fgervais/kicad-library/0ZCJ0050AF2E/0ZCJ0050AF2E.step

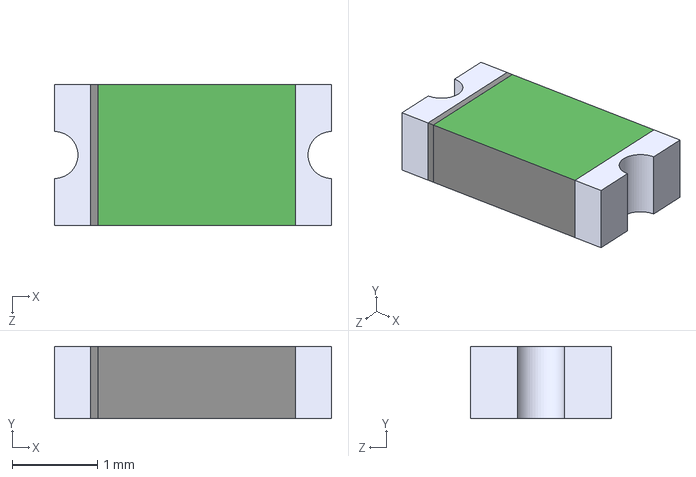
[picture p1: CAD file, 2022-11-03]
0ZCJ0050AF2E/0ZCJ0050AF2E.step
3.25 x 0.85 x 1.65 mm
