fgervais/kicad-library/1571563-9/c-1571563-9-v-3d.stp

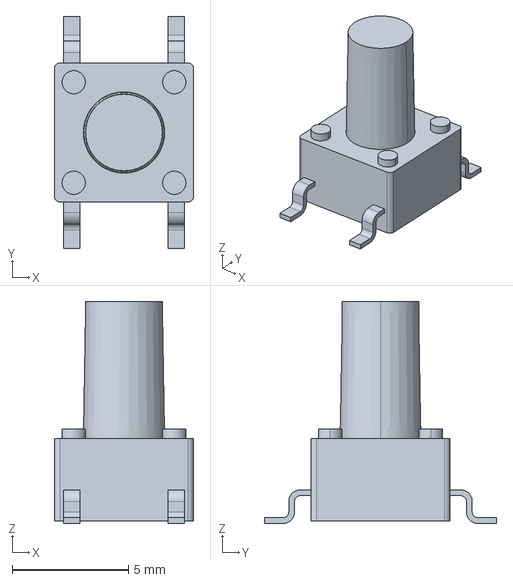
[picture p2: CAD file, 2022-03-16]
1571563-9/c-1571563-9-v-3d.stp
6.00 x 10.0 x 9.56 mm
