fgervais/kicad-library/22R686MC/22R686MC.step

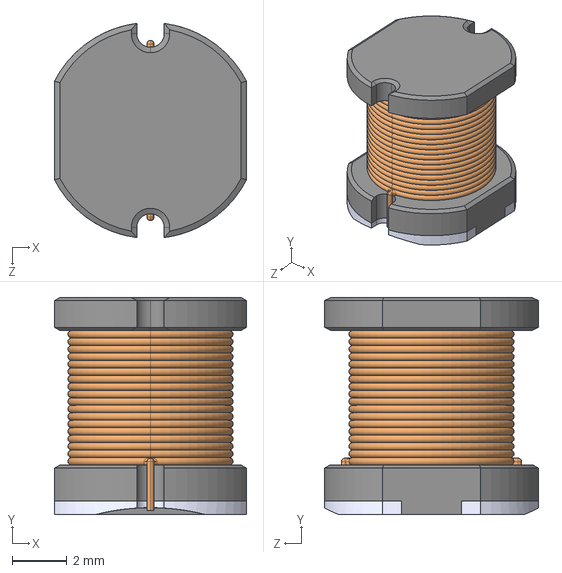
[picture p3: CAD file, 2022-11-13]
22R686MC/22R686MC.step
7.00 x 7.90 x 7.80 mm
