fgervais/kicad-library/3dmodels/C_0603_1608Metric.step

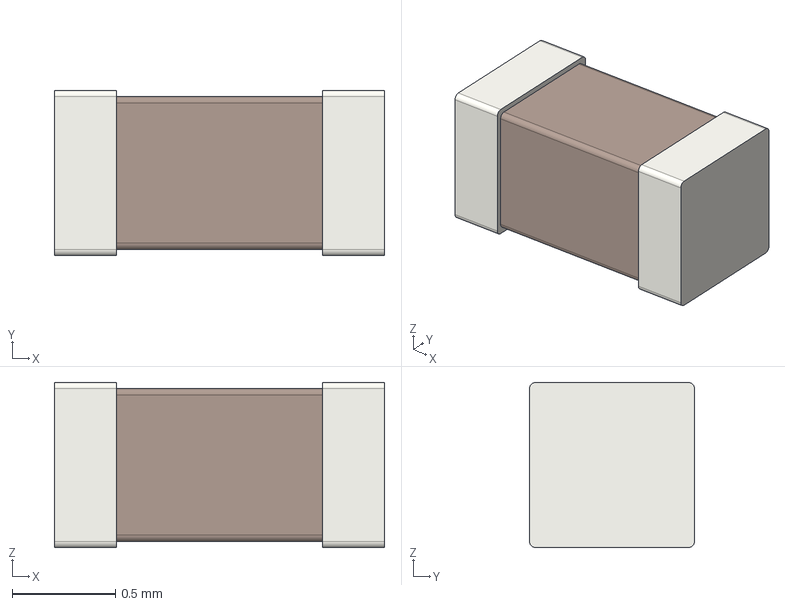
[picture p4: CAD file, 2026-03-07]
3dmodels/C_0603_1608Metric.step
1.60 x 0.8 x 0.8 mm
