fgervais/kicad-library/ADS1219IPWR/ADS1219IPWR.step

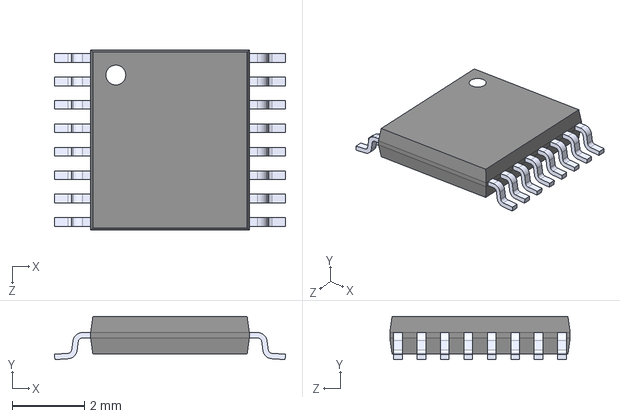
[picture p5: CAD file, 2022-04-10]
ADS1219IPWR/ADS1219IPWR.step
6.40 x 1.20 x 5.00 mm
