fgervais/kicad-library/AP63300WU-7/sot-23-6.stp

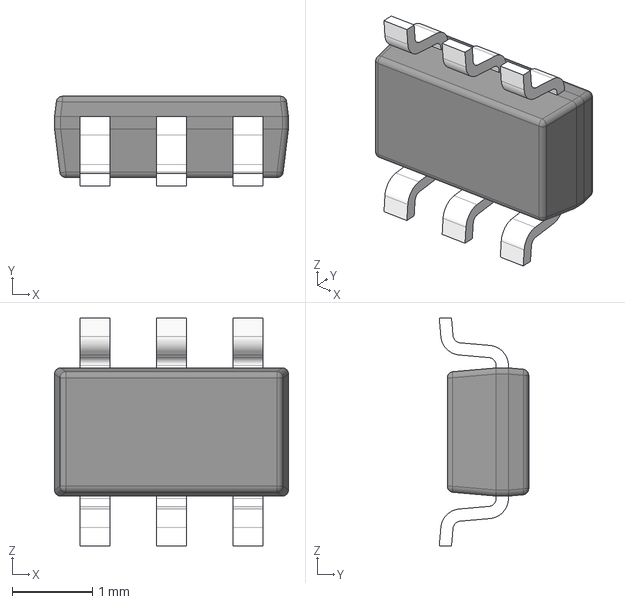
[picture p6: CAD file, 2023-01-06]
AP63300WU-7/sot-23-6.stp
2.92 x 1.12 x 2.84 mm
BODY_MF06A
LEAD_MF06A x 6
