fgervais/kicad-library/AS7341-DLGT/AS7341-DLGT.step

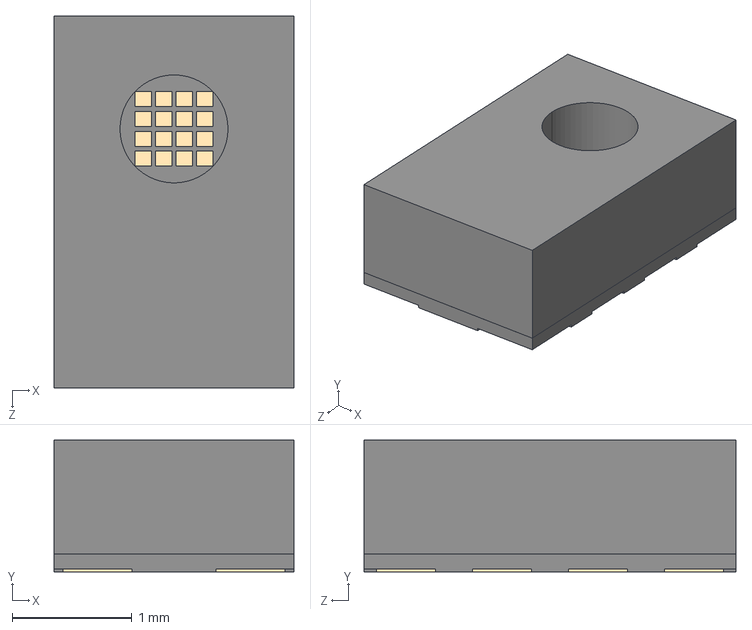
[picture p7: CAD file, 2022-04-02]
AS7341-DLGT/AS7341-DLGT.step
2.00 x 1.10 x 3.10 mm
