fgervais/kicad-library/B2B-PH-K-S(LF)(SN)/B2B-PH-K-S(LF)(SN)--3DModel-STEP-56544.STEP

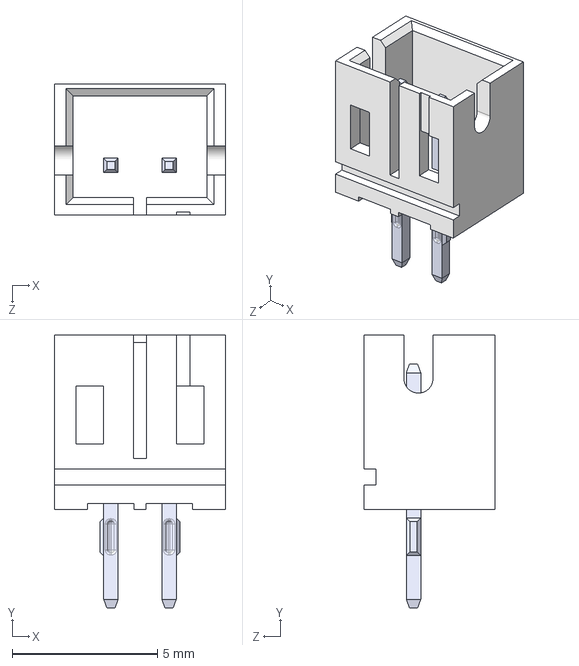
[picture p8: CAD file, 2020-11-15]
B2B-PH-K-S(LF)(SN)/B2B-PH-K-S(LF)(SN)--3DModel-STEP-56544.STEP
5.90 x 9.40 x 4.50 mm
