fgervais/kicad-library/B3FS-1010/B3FS-1010.stp

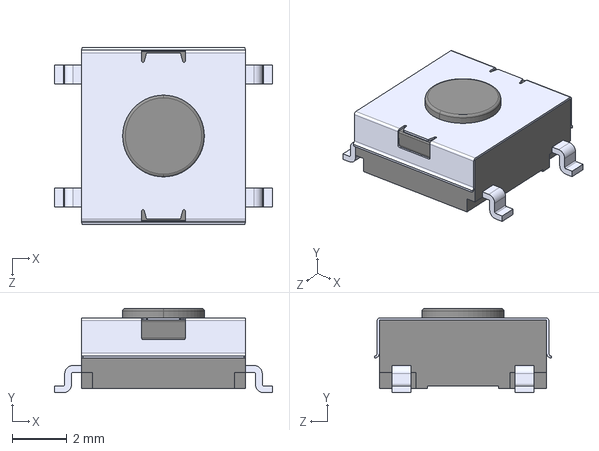
[picture p9: CAD file, 2022-03-24]
B3FS-1010/B3FS-1010.stp
8.00 x 3.10 x 6.50 mm
