fgervais/kicad-library/BA2032SM/BA2032SM.step

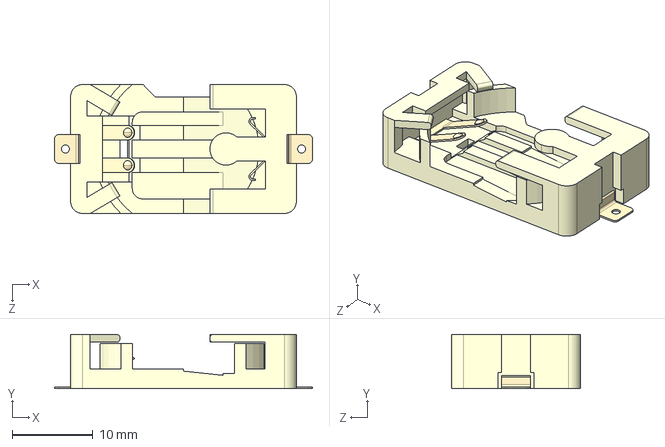
[picture p10: CAD file, 2022-03-16]
BA2032SM/BA2032SM.step
32.0 x 6.70 x 16.0 mm
