fgervais/kicad-library/BK-5058-SM/BK-5058-SM.step

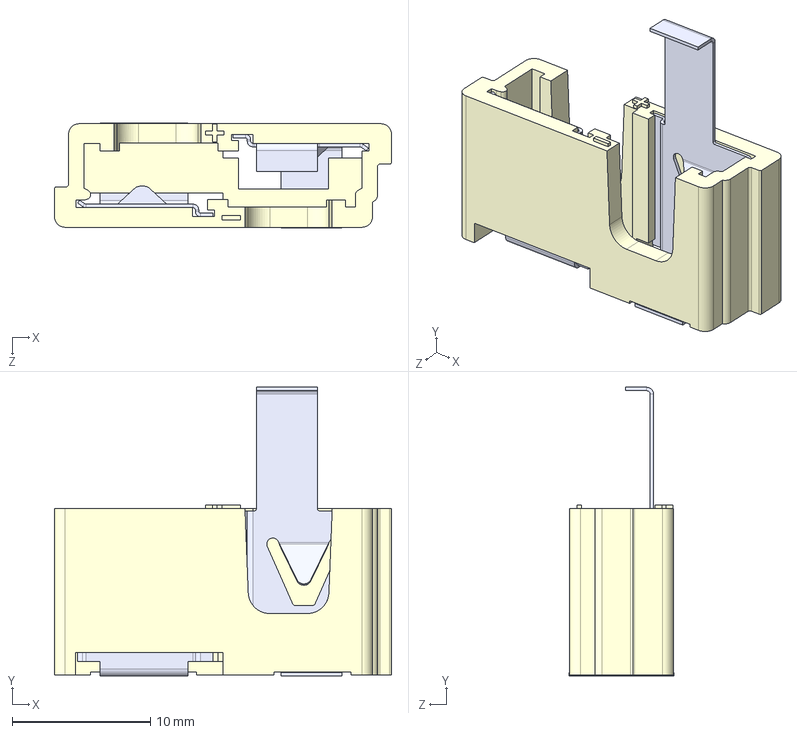
[picture p11: CAD file, 2022-11-15]
BK-5058-SM/BK-5058-SM.step
24.4 x 20.9 x 7.57 mm
