fgervais/kicad-library/BK-912/BK-912-TR.step

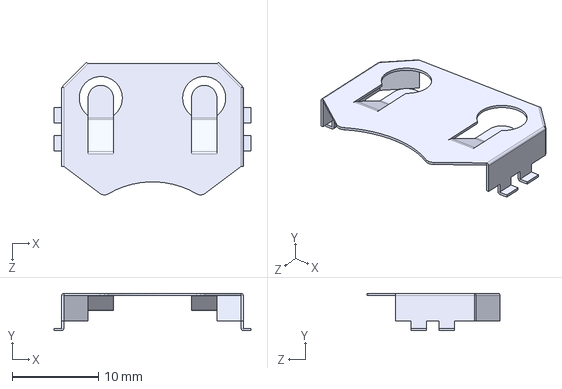
[picture p12: CAD file, 2022-11-17]
BK-912/BK-912-TR.step
22.9 x 4.32 x 15.4 mm
