fgervais/kicad-library/BM06B-SRSS-TB(LF)(SN)/BM06B-SRSS-TB.STEP

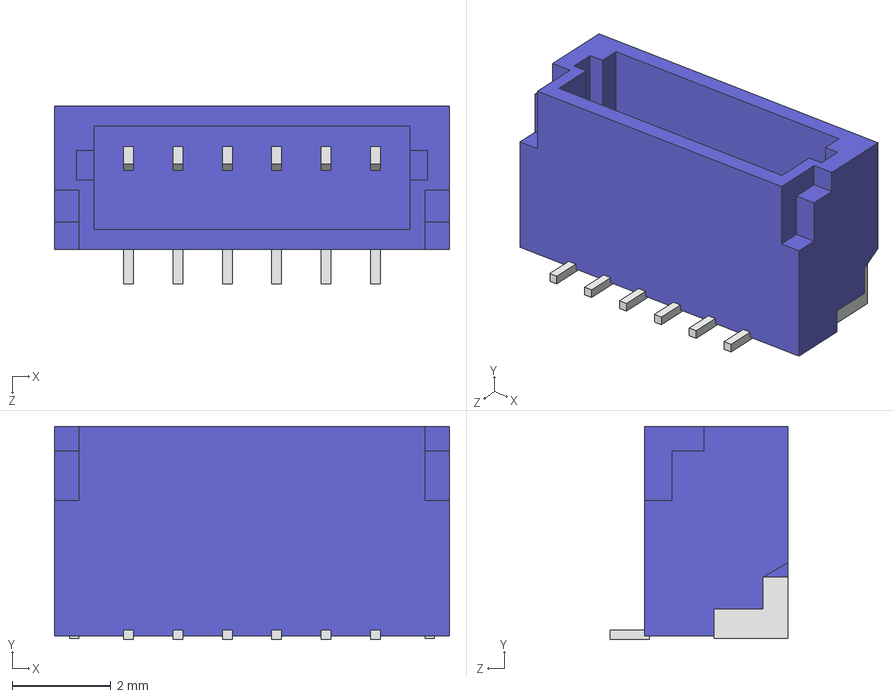
[picture p13: CAD file, 2021-02-07]
BM06B-SRSS-TB(LF)(SN)/BM06B-SRSS-TB.STEP
8.00 x 4.32 x 3.60 mm
