fgervais/kicad-library/BSS138W/SOT-323_SC-70.step

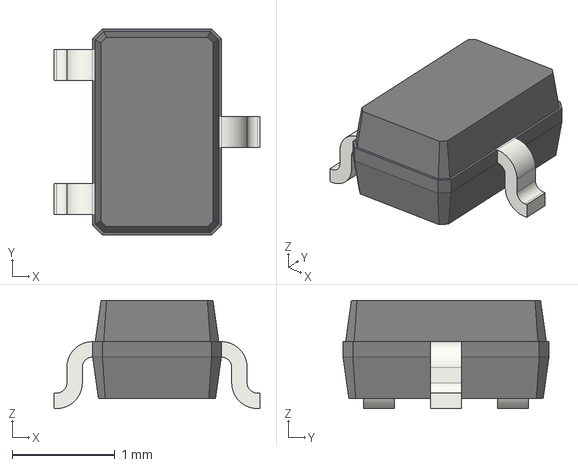
[picture p14: CAD file, 2024-10-14]
BSS138W/SOT-323_SC-70.step
2.00 x 2.00 x 1.05 mm
