fgervais/kicad-library/CL-SB-22A-02T/CL-SB-22A-02T.step

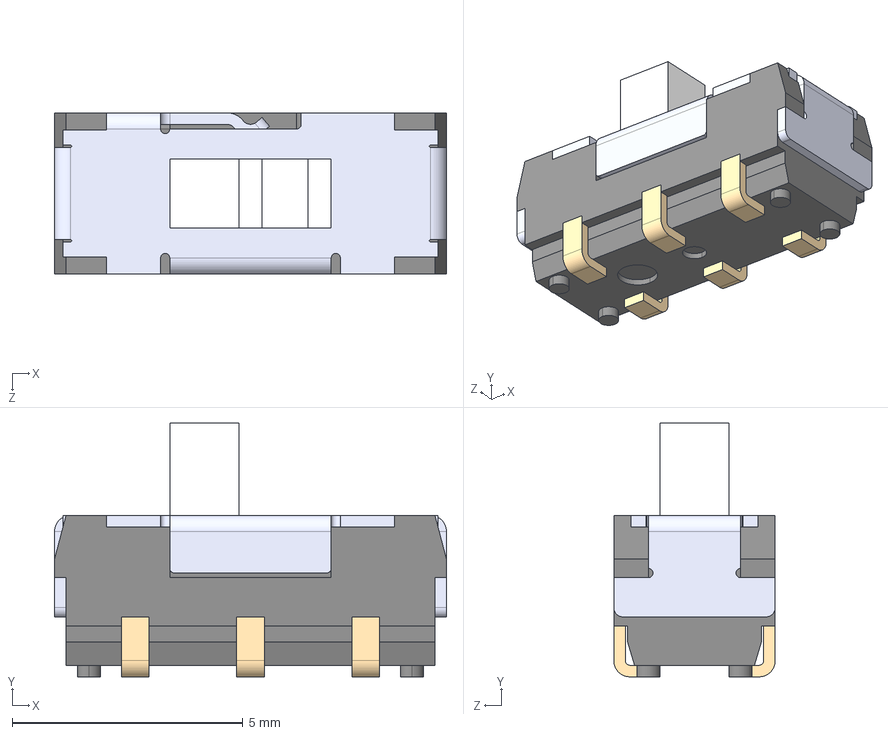
[picture p15: CAD file, 2022-11-02]
CL-SB-22A-02T/CL-SB-22A-02T.step
8.50 x 5.50 x 3.50 mm
