fgervais/kicad-library/CNCTECH_3220-26-0200-00/3220-26-0200-00.stp

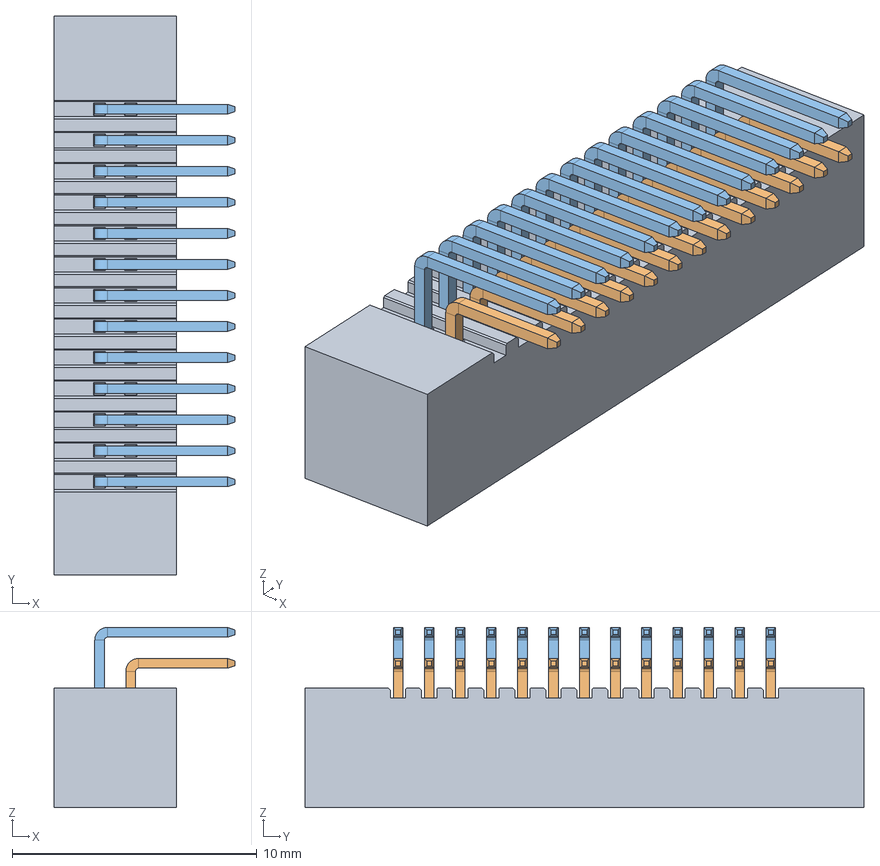
[picture p16: CAD file, 2025-05-09]
CNCTECH_3220-26-0200-00/3220-26-0200-00.stp
7.40 x 22.9 x 7.37 mm
801-2195R-26
802-2195R-XXG-L x 13
802-2195R-XXG x 13
