fgervais/kicad-library/CNCTECH_3220-26-0300-00/3220-26-0300-00.step

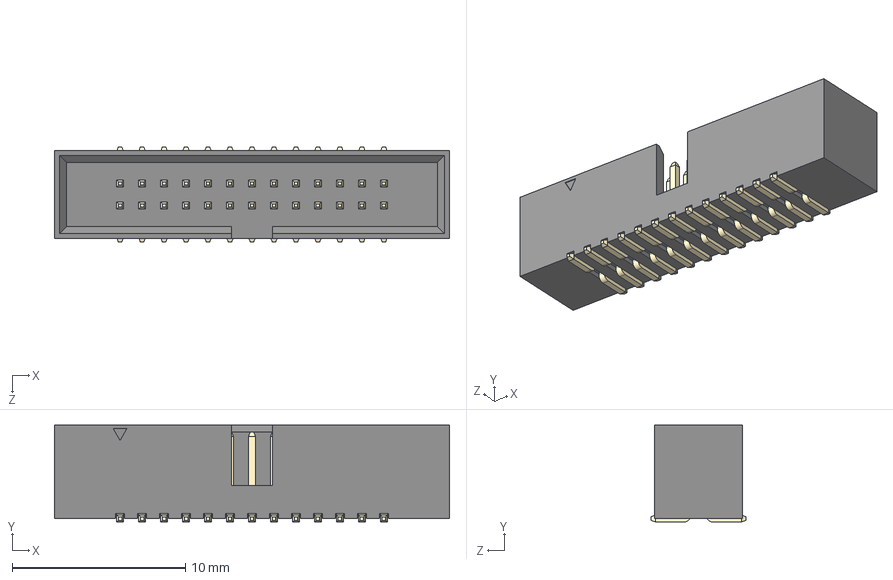
[picture p17: CAD file, 2025-05-14]
CNCTECH_3220-26-0300-00/3220-26-0300-00.step
22.8 x 5.60 x 5.50 mm
3220-xx-0300-00 body_26
Pin^3220-xx-0300-00 x 13
MirrorPin^3220-xx-0300-00 x 13
