fgervais/kicad-library/Conn_Molex_393570002/Molex_-_393570002.step

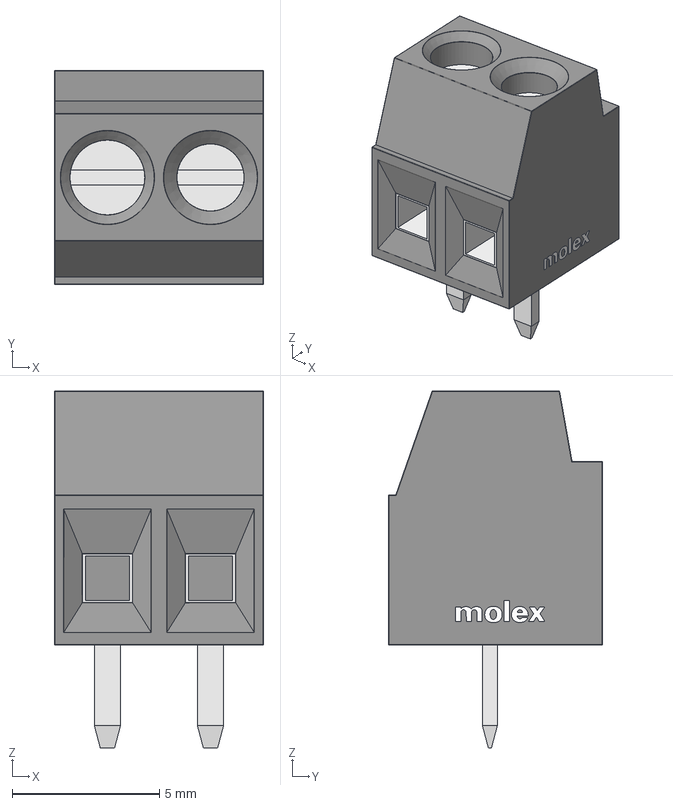
[picture p18: CAD file, 2021-02-07]
Conn_Molex_393570002/Molex_-_393570002.step
7.11 x 7.29 x 12.1 mm
393570002_Body
393570002_Contacts
393570002_Screw
393570002_Terminals
Molex
