fgervais/kicad-library/Conn_Molex_393570004/Molex_-_393570004.step

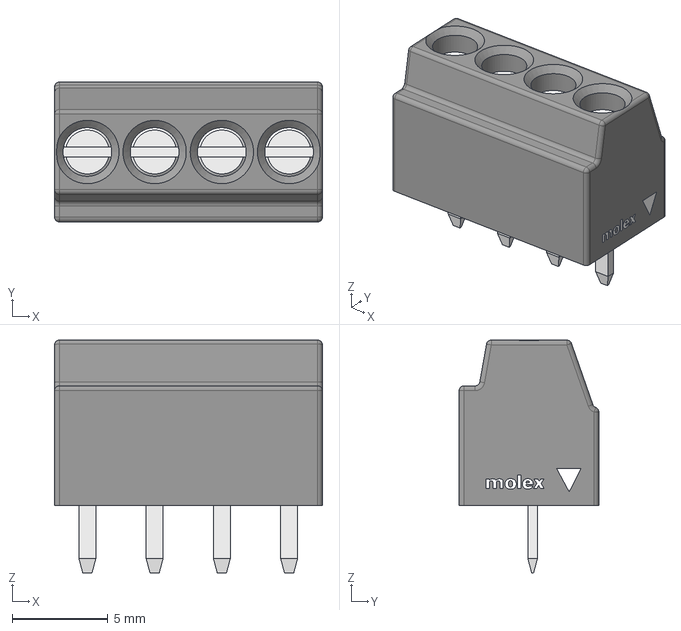
[picture p19: CAD file, 2021-02-07]
Conn_Molex_393570004/Molex_-_393570004.step
14.0 x 7.29 x 12.1 mm
