fgervais/kicad-library/CUS10S30,H3F/DIO_CUS520_H3F.step

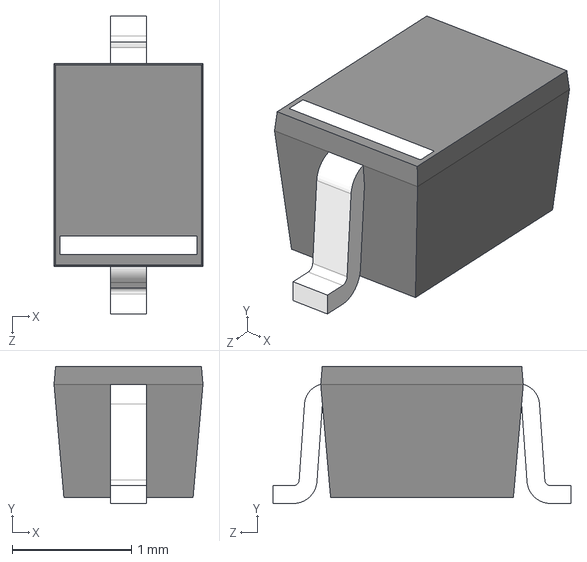
[picture p20: CAD file, 2022-01-06]
CUS10S30,H3F/DIO_CUS520_H3F.step
1.25 x 1.15 x 2.50 mm
