fgervais/kicad-library/DS2482S-100/DS2482S-100_.step

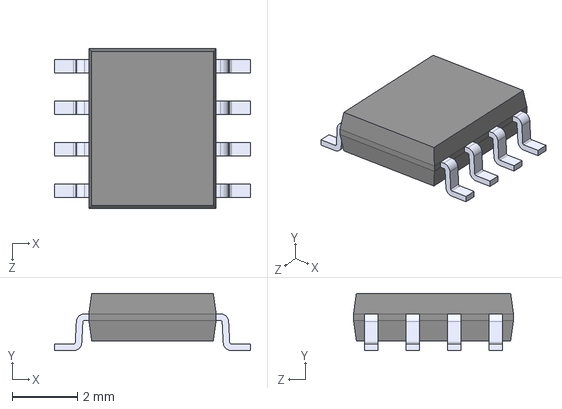
[picture p21: CAD file, 2021-08-31]
DS2482S-100/DS2482S-100_.step
6.00 x 1.75 x 4.90 mm
