fgervais/kicad-library/ESP32-C3-WROOM-02-H4/ESP32-C3-WROOM-02-H4.step

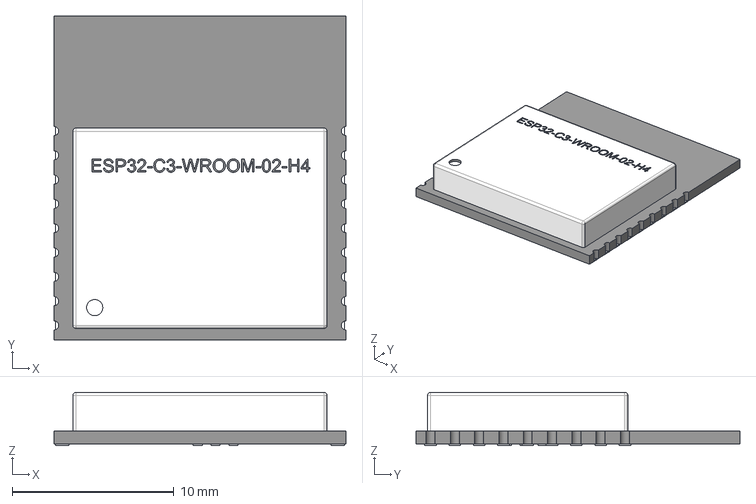
[picture p22: CAD file, 2021-09-25]
ESP32-C3-WROOM-02-H4/ESP32-C3-WROOM-02-H4.step
18.0 x 20.0 x 3.30 mm
Pins
