fgervais/kicad-library/ISM330DHCXTR/ISM330DHCXTR.step

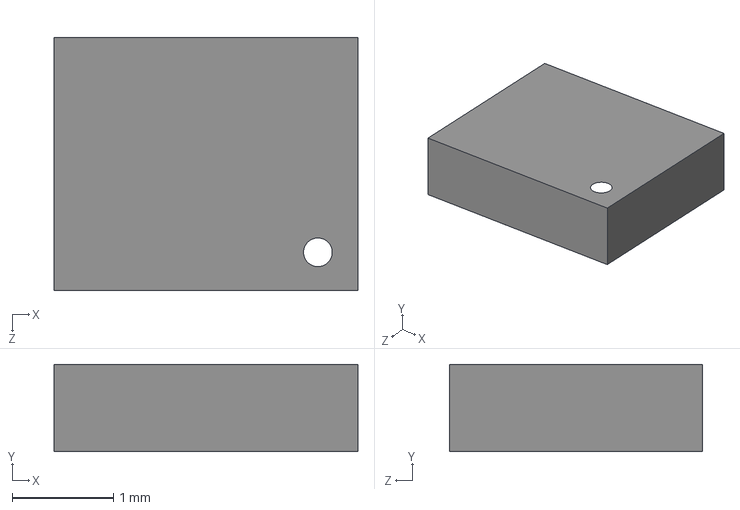
[picture p23: CAD file, 2022-09-17]
ISM330DHCXTR/ISM330DHCXTR.step
3.00 x 0.86 x 2.50 mm
