fgervais/kicad-library/LBR2518T100K/L_QEA251818.STEP

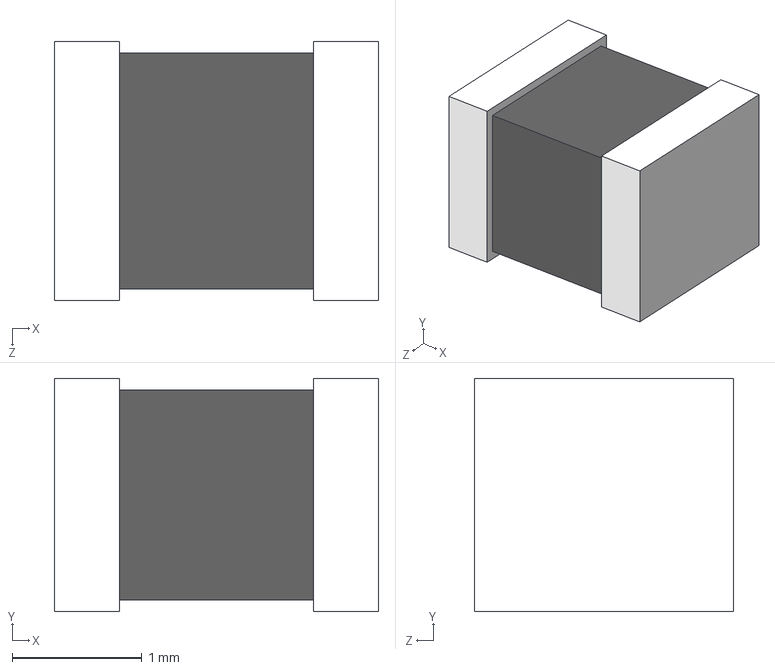
[picture p24: CAD file, 2023-01-07]
LBR2518T100K/L_QEA251818.STEP
2.50 x 1.80 x 2.00 mm
