fgervais/kicad-library/LMV792MM/LMV792MM.step

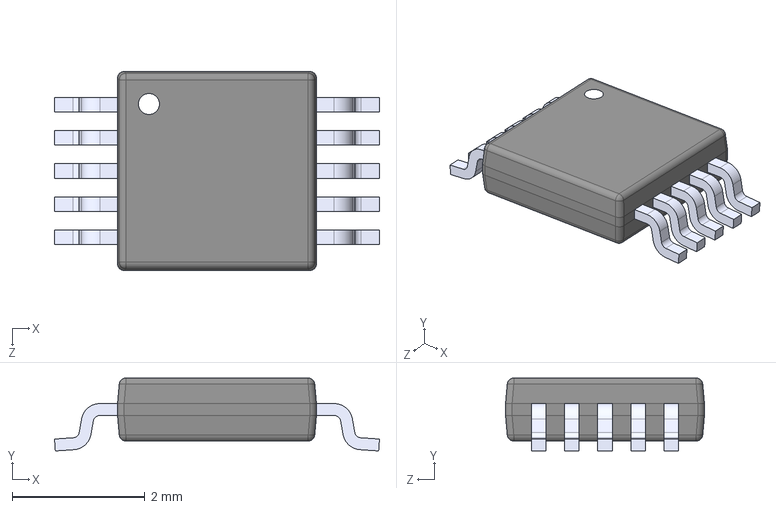
[picture p25: CAD file, 2022-04-22]
LMV792MM/LMV792MM.step
4.90 x 1.10 x 3.00 mm
