fgervais/kicad-library/LSF0204DPWR/LSF0204DPWR.step

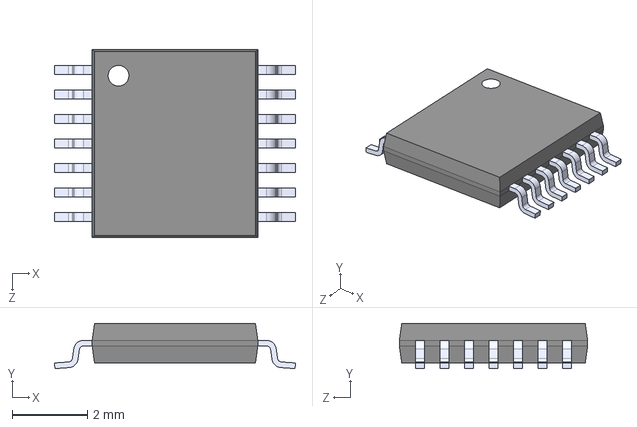
[picture p26: CAD file, 2022-04-10]
LSF0204DPWR/LSF0204DPWR.step
6.40 x 1.20 x 5.00 mm
