fgervais/kicad-library/MELEXIS_TECHNOLOGIES_NV_MLX90640ESF-BAA-000-TU/a549d9fa911df849d05683749dd4367124007292.step

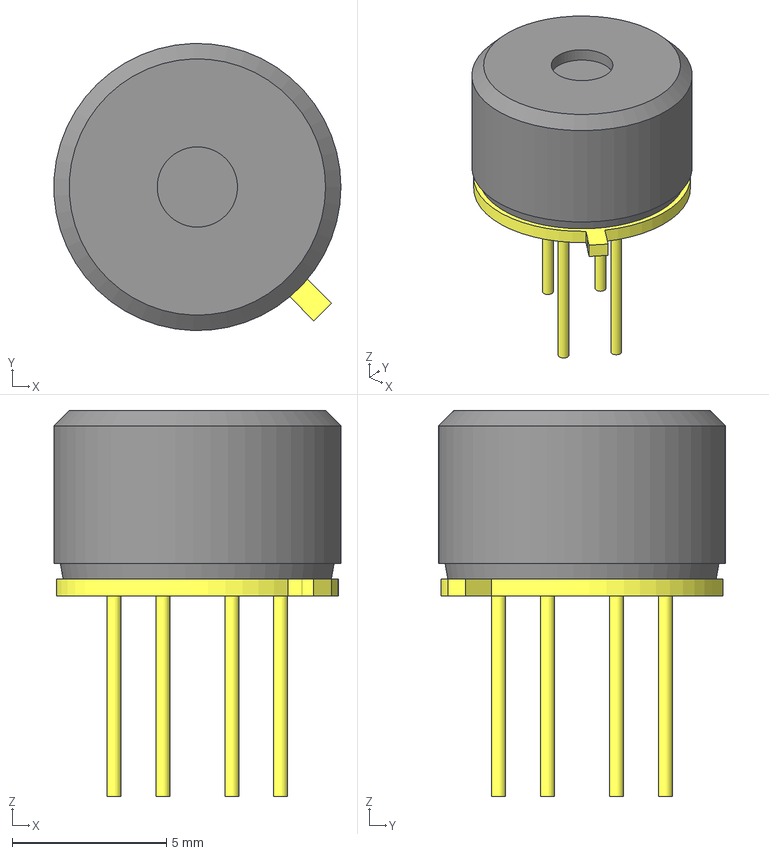
[picture p27: CAD file, 2020-11-15]
MELEXIS_TECHNOLOGIES_NV_MLX90640ESF-BAA-000-TU/a549d9fa911df849d05683749dd4367124007292.step
9.29 x 9.30 x 12.5 mm
base
sensor
pins
