fgervais/kicad-library/MS88SF3/MS88SF3.step

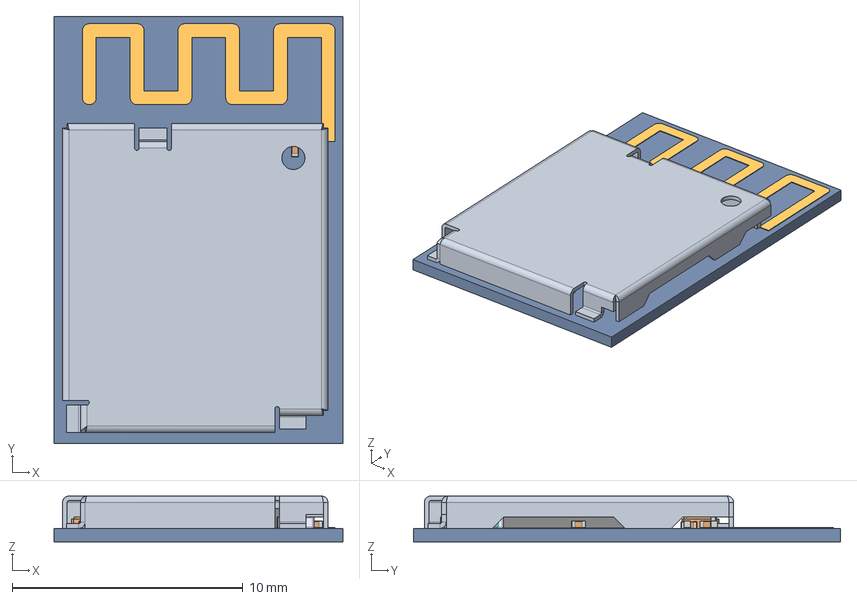
[picture p28: CAD file, 2022-07-01]
MS88SF3/MS88SF3.step
12.5 x 18.5 x 1.99 mm
Board
ANT-2.4G-16
Open_CASCADE_STEP_translator_6.8_9.1
Open_CASCADE_STEP_translator_6.8_9.2.1
pinShape x 184
2012crystal
epson2016
88sf3190624
