fgervais/kicad-library/MUN5214DW1T1G/MUN5214DW1T1G.models/On_Semiconductor_-_MUN5214DW1T1G.step

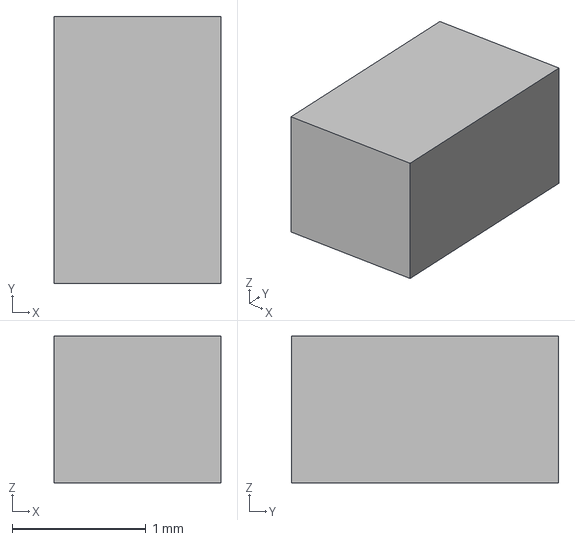
[picture p29: CAD file, 2020-12-27]
MUN5214DW1T1G/MUN5214DW1T1G.models/On_Semiconductor_-_MUN5214DW1T1G.step
1.25 x 2.00 x 1.10 mm
