fgervais/kicad-library/PEC11S-9213K-S0015/RotaryEncoder_Bourns_PEC11S-929K-S0015-Switch_Vertical.step

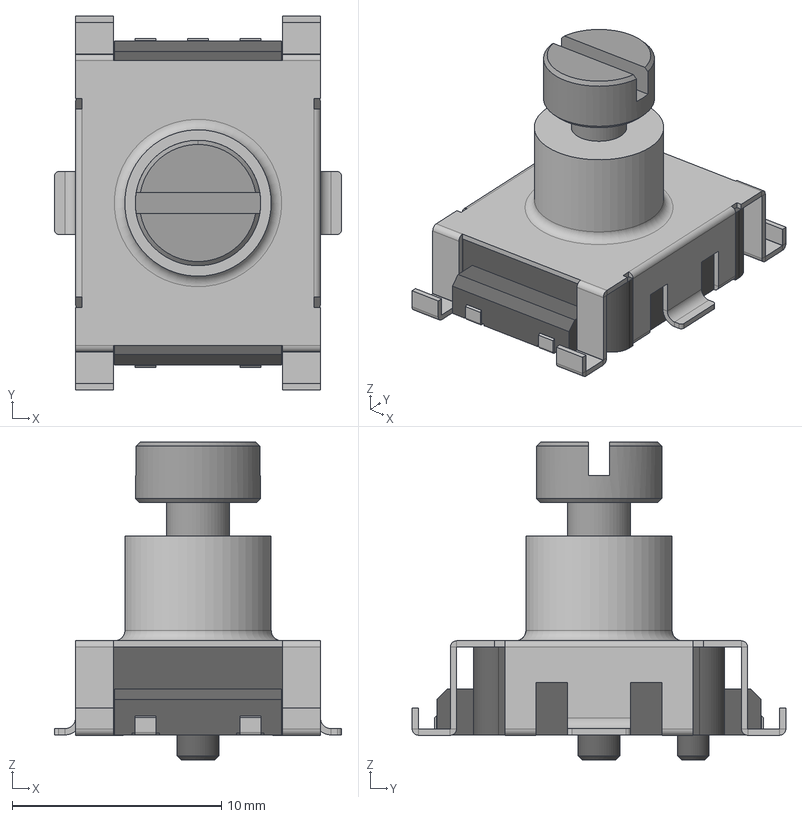
[picture p30: CAD file, 2023-01-02]
PEC11S-9213K-S0015/RotaryEncoder_Bourns_PEC11S-929K-S0015-Switch_Vertical.step
13.7 x 17.9 x 15.2 mm
Shaft
Shield
Pads
