fgervais/kicad-library/PJ-036AH-SMT-TR/CUI_DEVICES_PJ-036AH-SMT-TR.step

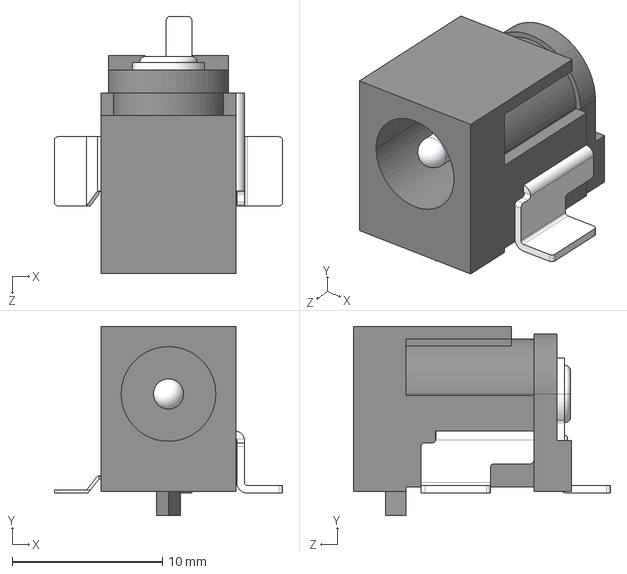
[picture p31: CAD file, 2022-04-10]
PJ-036AH-SMT-TR/CUI_DEVICES_PJ-036AH-SMT-TR.step
15.2 x 12.6 x 17.1 mm
