fgervais/kicad-library/PKM13EPYH4000-A0/PKM13EPYH4000-A0.step

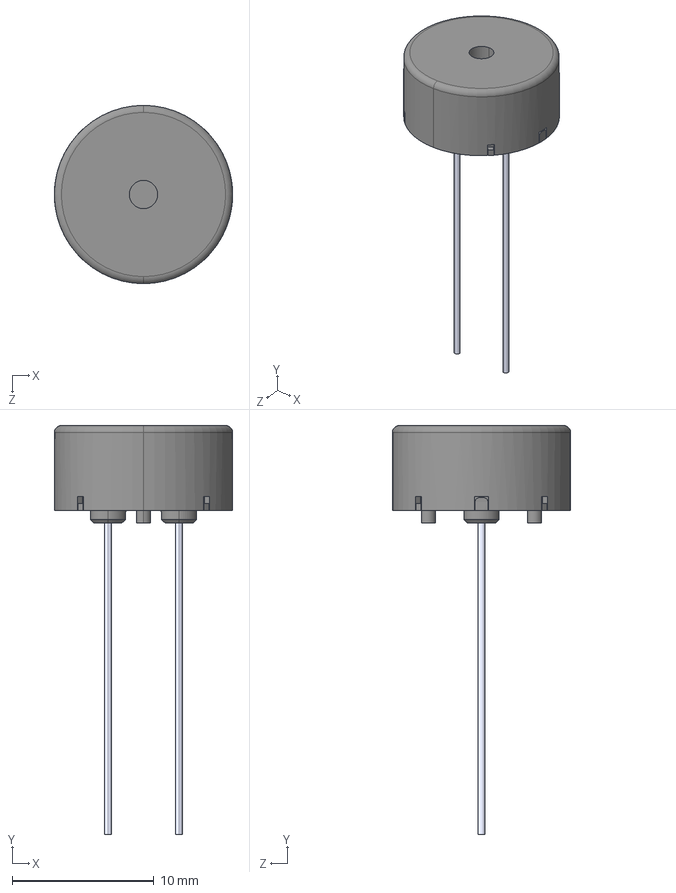
[picture p32: CAD file, 2022-11-13]
PKM13EPYH4000-A0/PKM13EPYH4000-A0.step
12.6 x 28.9 x 12.6 mm
