fgervais/kicad-library/PS1240P02BT/PS1240P02BT--3DModel-STEP-56544.STEP

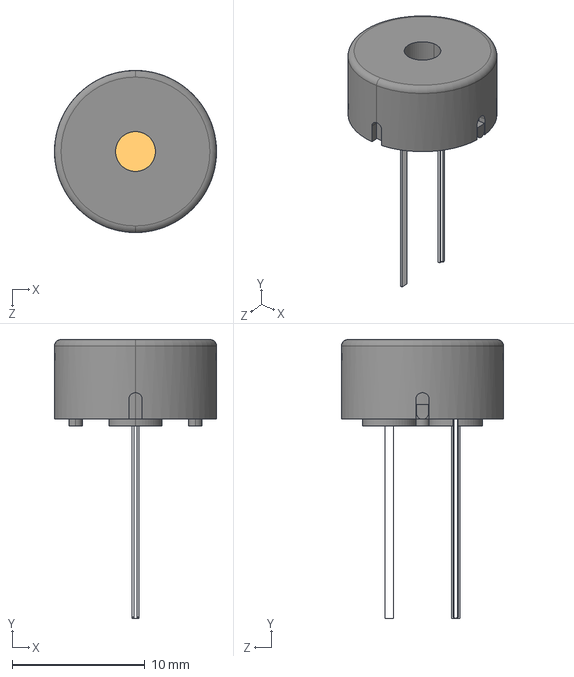
[picture p33: CAD file, 2020-11-15]
PS1240P02BT/PS1240P02BT--3DModel-STEP-56544.STEP
12.2 x 21.0 x 12.2 mm
