fgervais/kicad-library/PTS810-SJM-250-SMTR-LFS/PTS810_SJM_250_SMTR_LFS.step

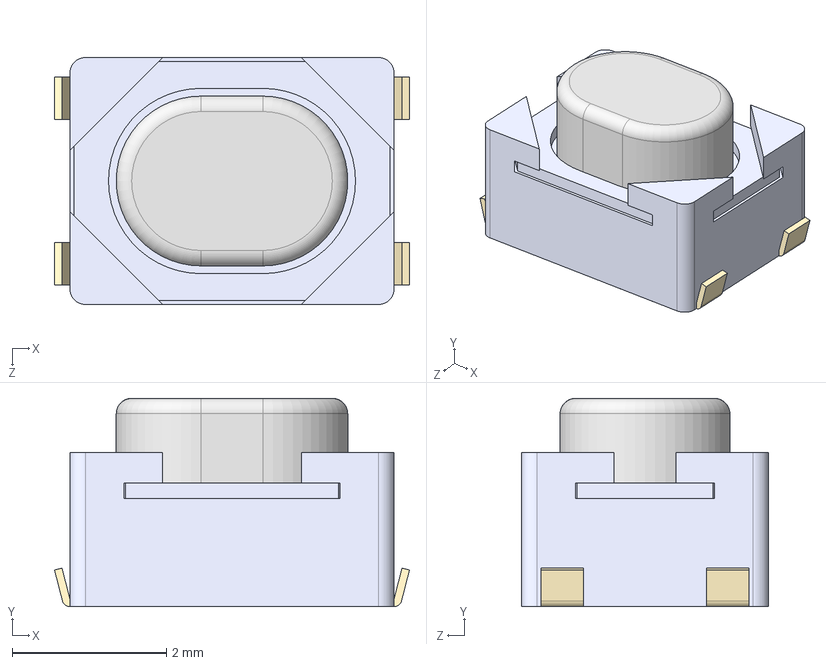
[picture p34: CAD file, 2024-04-25]
PTS810-SJM-250-SMTR-LFS/PTS810_SJM_250_SMTR_LFS.step
4.60 x 2.70 x 3.20 mm
