fgervais/kicad-library/PWR263S-35/pwr263s-35.stp

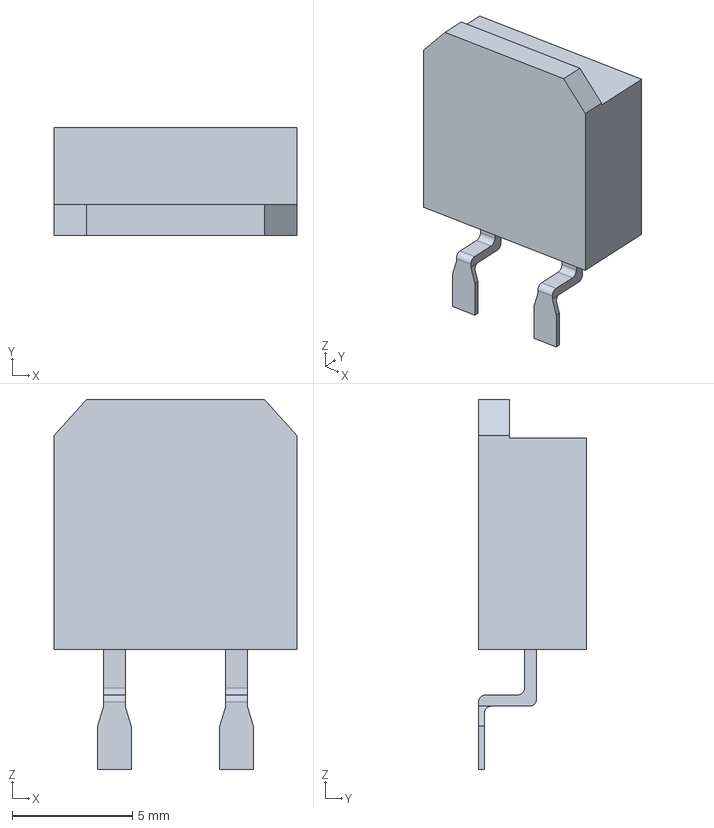
[picture p35: CAD file, 2025-01-25]
PWR263S-35/pwr263s-35.stp
10.1 x 4.50 x 15.4 mm
