fgervais/kicad-library/RJHSE-5080/RJHSE-5080--3DModel-STEP-56544.STEP

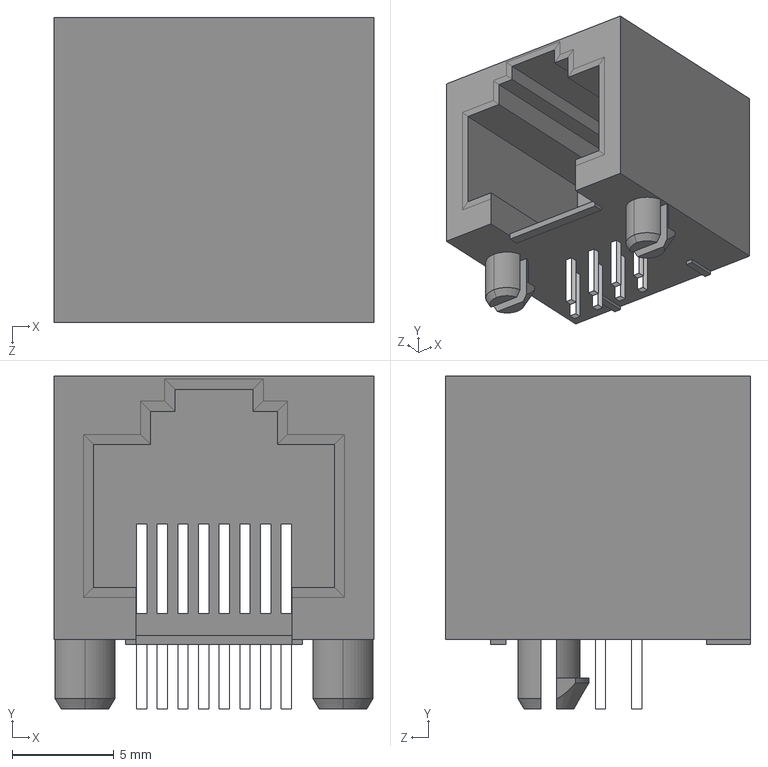
[picture p36: CAD file, 2020-11-15]
RJHSE-5080/RJHSE-5080--3DModel-STEP-56544.STEP
15.7 x 16.4 x 15.0 mm
