fgervais/kicad-library/S2B-PH-SM4-TB(LF)(SN)/S2B-PH-SM4-TB_LF__SN_.step

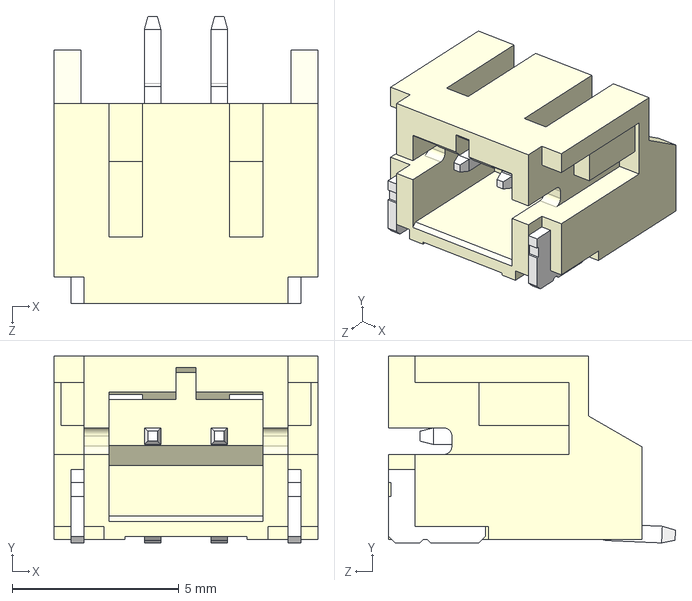
[picture p37: CAD file, 2022-08-24]
S2B-PH-SM4-TB(LF)(SN)/S2B-PH-SM4-TB_LF__SN_.step
7.90 x 5.60 x 8.60 mm
