fgervais/kicad-library/S6B-ZR(LF)(SN)/S6B-ZR.STEP

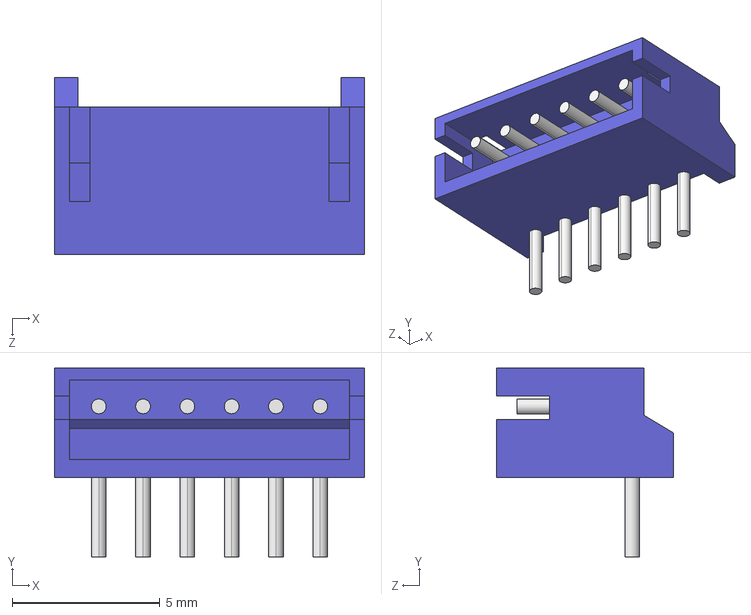
[picture p38: CAD file, 2021-01-30]
S6B-ZR(LF)(SN)/S6B-ZR.STEP
10.5 x 6.40 x 6.00 mm
