fgervais/kicad-library/S6B-ZR-SM4A-TF(LF)(SN)/S6B-ZR-SM4A-TF_LF__SN_.step

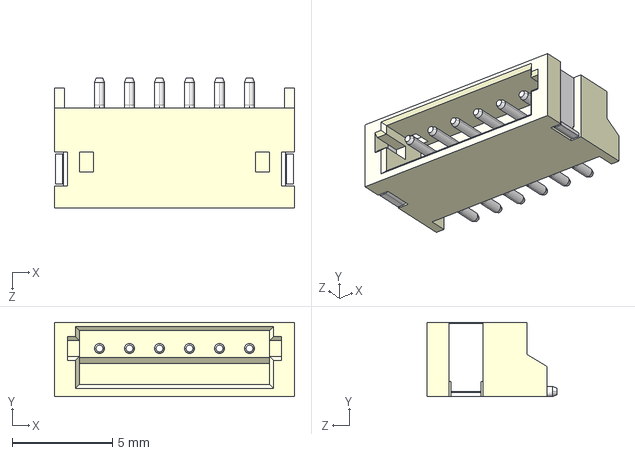
[picture p39: CAD file, 2021-01-31]
S6B-ZR-SM4A-TF(LF)(SN)/S6B-ZR-SM4A-TF_LF__SN_.step
12.0 x 3.70 x 6.50 mm
