fgervais/kicad-library/SM04B-SRSS-TB(LF)(SN)/SM04B-SRSS-TB_LF__SN_.step

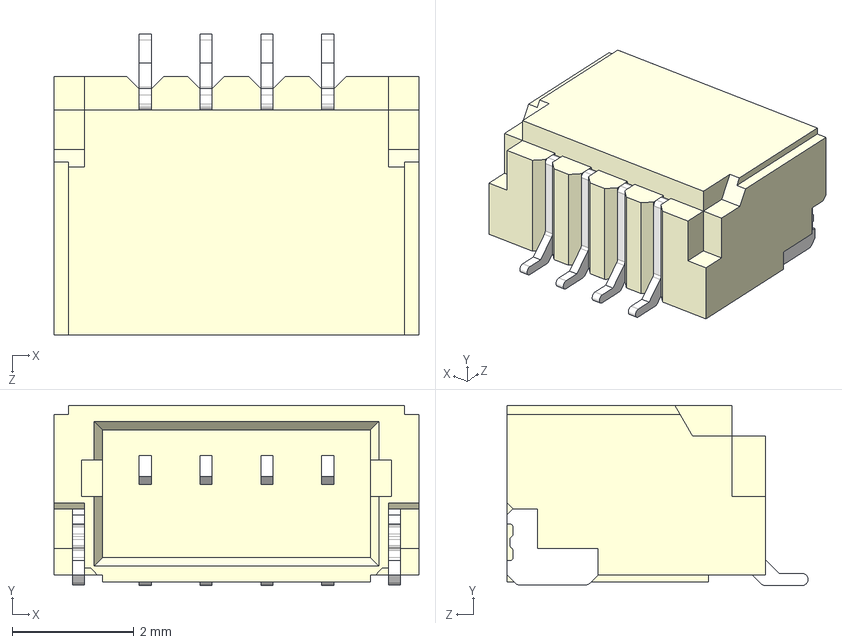
[picture p40: CAD file, 2021-05-08]
SM04B-SRSS-TB(LF)(SN)/SM04B-SRSS-TB_LF__SN_.step
6.00 x 2.96 x 4.95 mm
