fgervais/kicad-library/SM06B-SRSS-TB(LF)(SN)/SM06B-SRSS-TB_LF__SN_.step

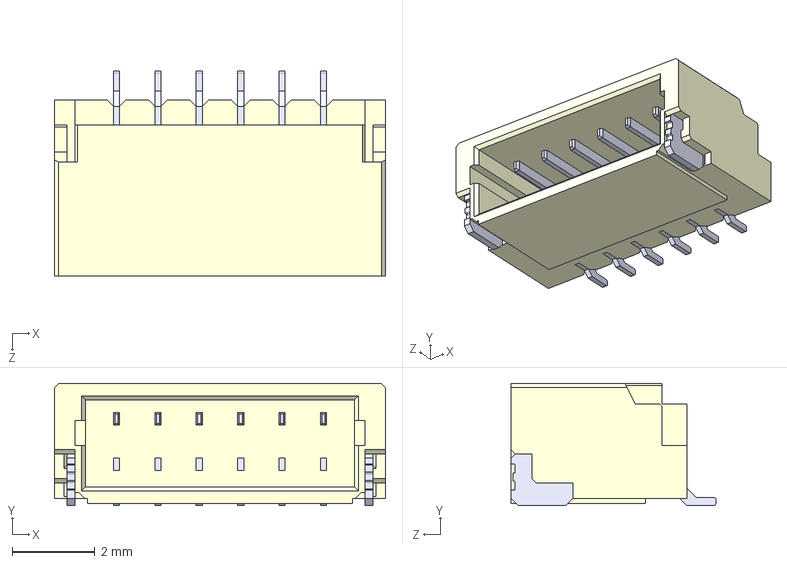
[picture p41: CAD file, 2021-02-02]
SM06B-SRSS-TB(LF)(SN)/SM06B-SRSS-TB_LF__SN_.step
8.00 x 2.95 x 4.95 mm
