fgervais/kicad-library/SM3ZS067U410-NUT1-R1200/sm3zs067u410-nut1-r1200.stp

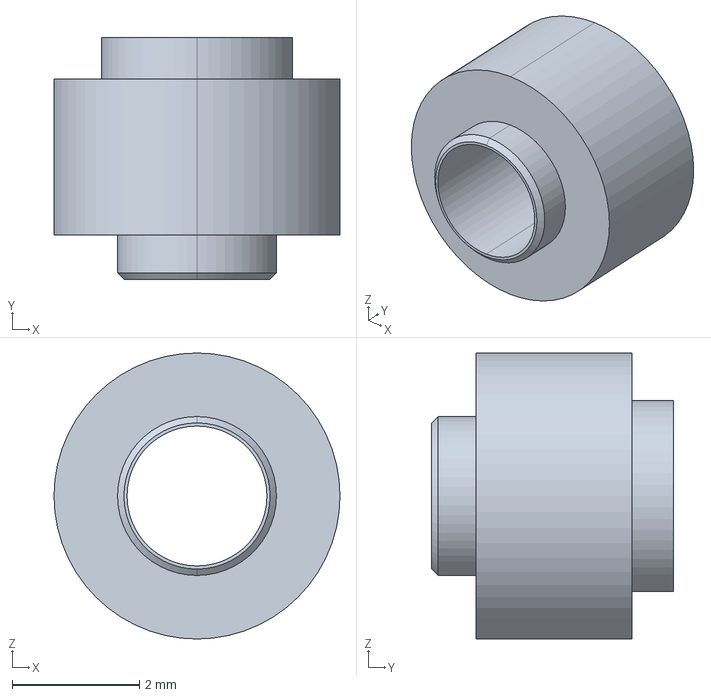
[picture p42: CAD file, 2021-01-18]
SM3ZS067U410-NUT1-R1200/sm3zs067u410-nut1-r1200.stp
4.50 x 3.80 x 4.50 mm
