fgervais/kicad-library/SSM6J214FE-TE85L-F/ES6.step

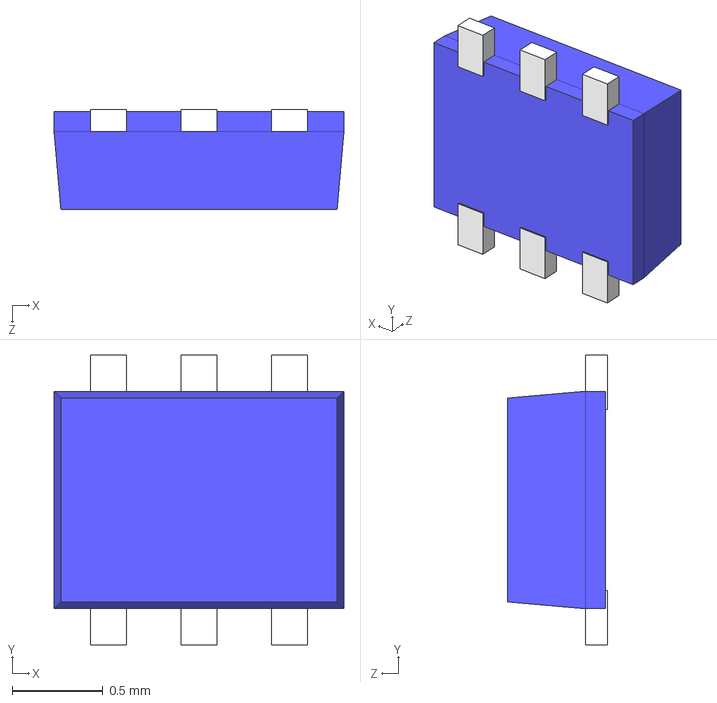
[picture p43: CAD file, 2022-01-08]
SSM6J214FE-TE85L-F/ES6.step
1.60 x 1.60 x 0.55 mm
