fgervais/kicad-library/step/User Library-C12880MA.STEP

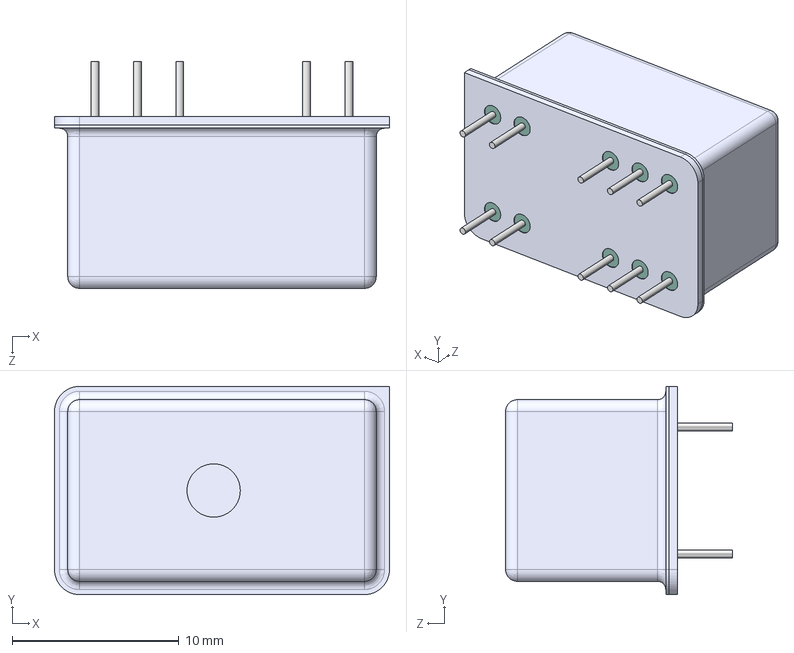
[picture p44: CAD file, 2022-04-23]
step/User Library-C12880MA.STEP
20.1 x 12.5 x 13.6 mm
Zakladna
Priechodka x 10
Pin x 10
Zakladna_2
