fgervais/kicad-library/TC33X_2_504E/TC33X-2-504E.step

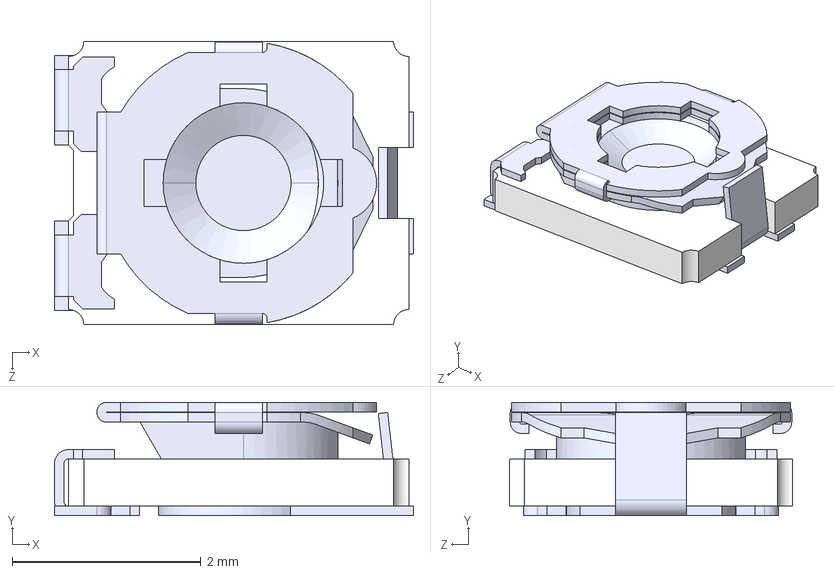
[picture p45: CAD file, 2025-01-04]
TC33X_2_504E/TC33X-2-504E.step
3.80 x 1.20 x 3.00 mm
