fgervais/kicad-library/TCA9548APWR/TCA9548APWR.step

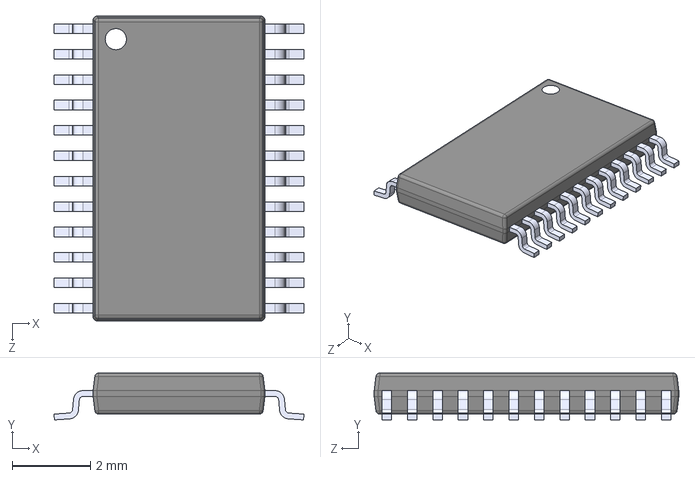
[picture p46: CAD file, 2025-05-05]
TCA9548APWR/TCA9548APWR.step
6.40 x 1.20 x 7.80 mm
