fgervais/kicad-library/TMP117AIDRVR/TMP117AIDRVR.step

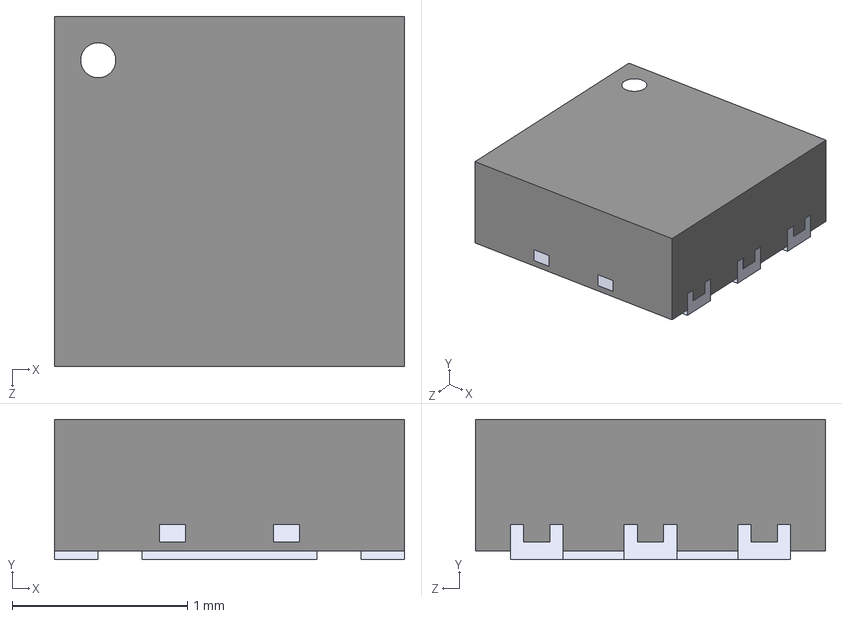
[picture p47: CAD file, 2024-04-01]
TMP117AIDRVR/TMP117AIDRVR.step
2.00 x 0.8 x 2.00 mm
