fgervais/kicad-library/TPS7A2033PDBVR/TPS7A2033PDBVR.step

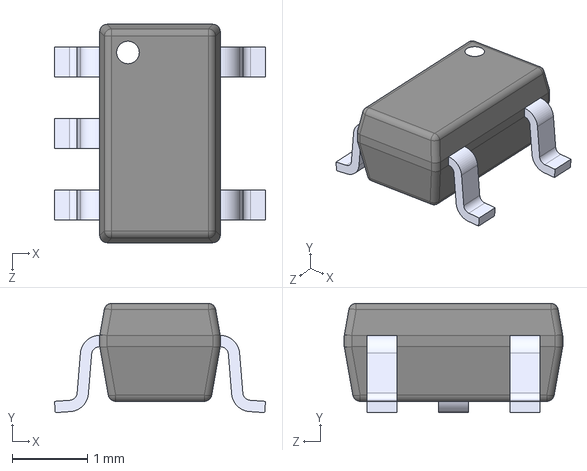
[picture p48: CAD file, 2022-04-02]
TPS7A2033PDBVR/TPS7A2033PDBVR.step
2.80 x 1.45 x 2.90 mm
