fgervais/kicad-library/TSM-102-01-L-SH-TR/TSM-102-01-L-SH-TR.step

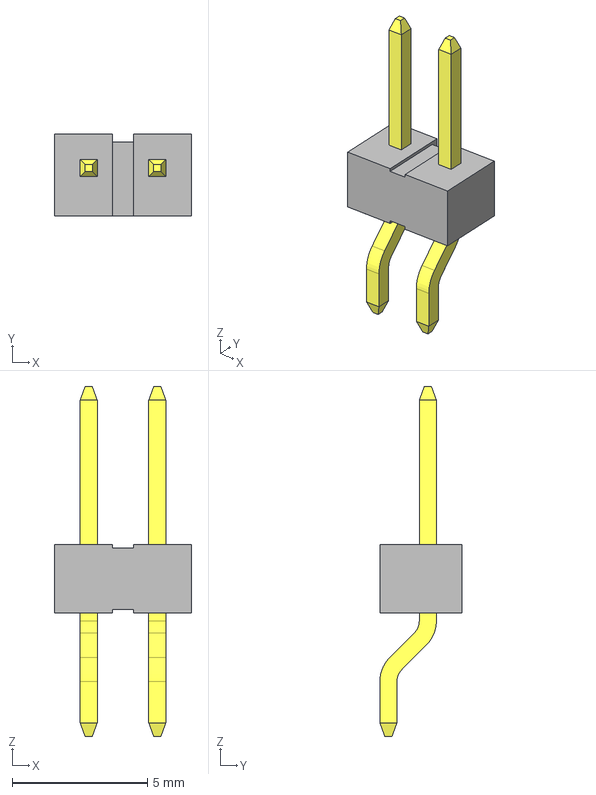
[picture p49: CAD file, 2022-11-13]
TSM-102-01-L-SH-TR/TSM-102-01-L-SH-TR.step
5.08 x 3.05 x 13.0 mm
T-1S6-08(-01-2-SH)
TSM-102-01-SH_body
