fgervais/kicad-library/TXU0204BQAR/BQA0014A.stp

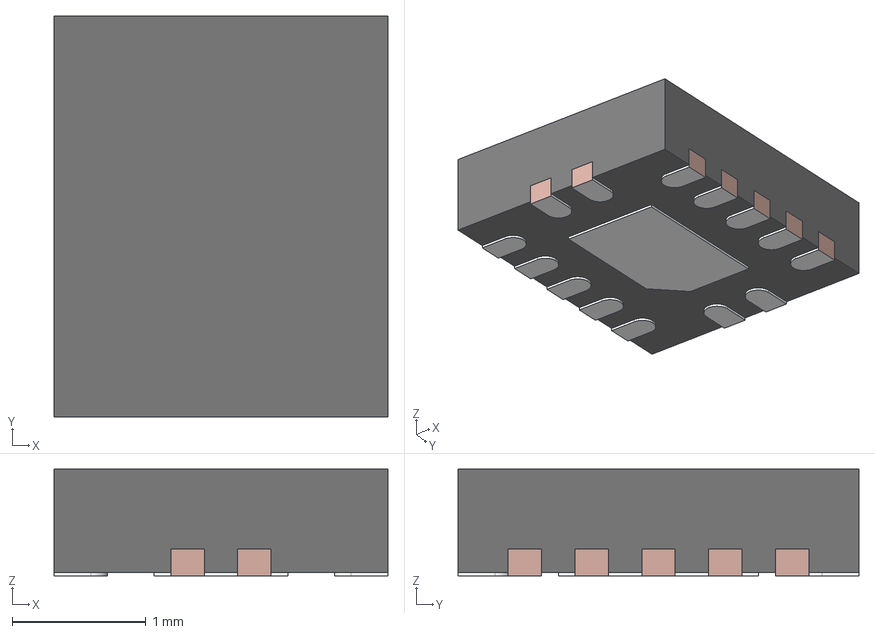
[picture p50: CAD file, 2022-11-02]
TXU0204BQAR/BQA0014A.stp
2.50 x 3.00 x 0.8 mm
FRAME
