fgervais/kicad-library/TXU0204PWR/TXU0204PWR.stp

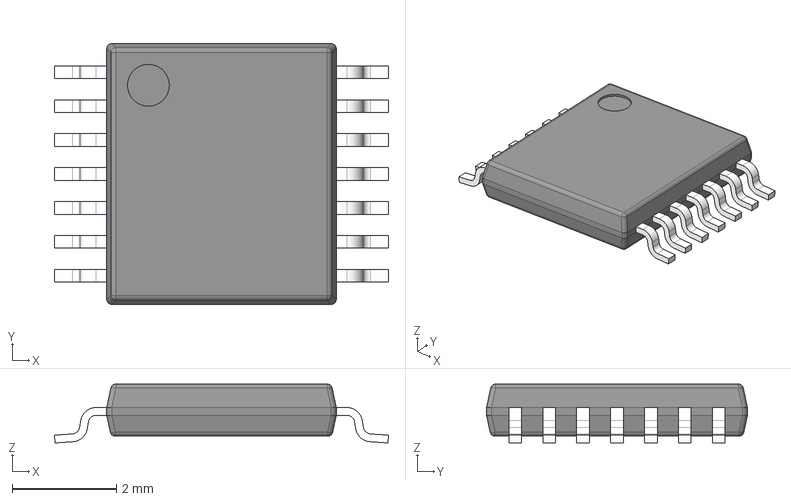
[picture p51: CAD file, 2022-04-22]
TXU0204PWR/TXU0204PWR.stp
6.40 x 5.00 x 1.13 mm
BODY-TSSOP
LEAD-TSSOP x 14
PIN1
