fgervais/kicad-library/USB4105-GF-A/USB4105-GF-A.step

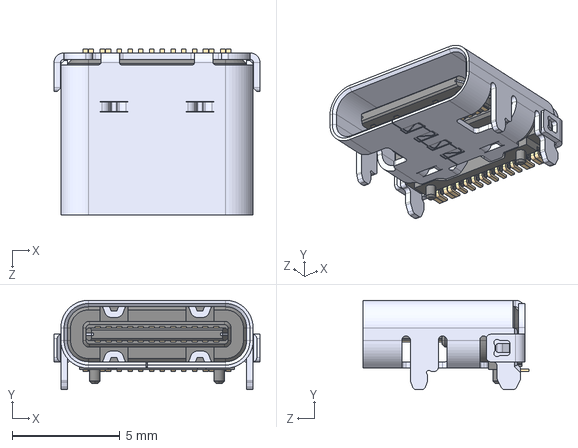
[picture p52: CAD file, 2022-01-06]
USB4105-GF-A/USB4105-GF-A.step
9.58 x 4.16 x 7.71 mm
