fgervais/kicad-library/WAGO_2060-452-998-404/2060-452_998-404.stp

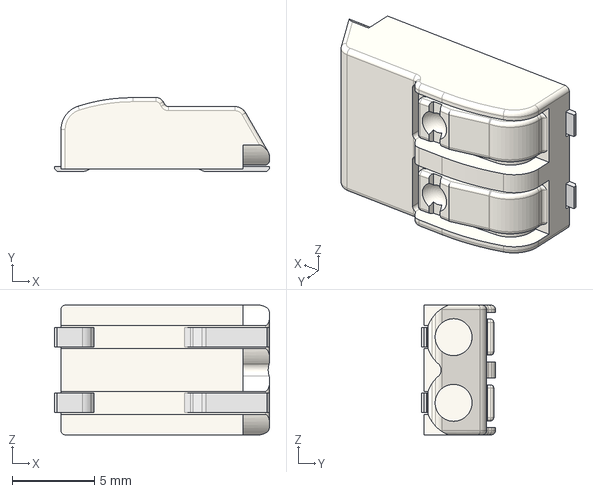
[picture p53: CAD file, 2025-01-28]
WAGO_2060-452-998-404/2060-452_998-404.stp
13.1 x 4.50 x 7.90 mm
