fgervais/kicad-library/3dmodels/C_1210_3225Metric.step

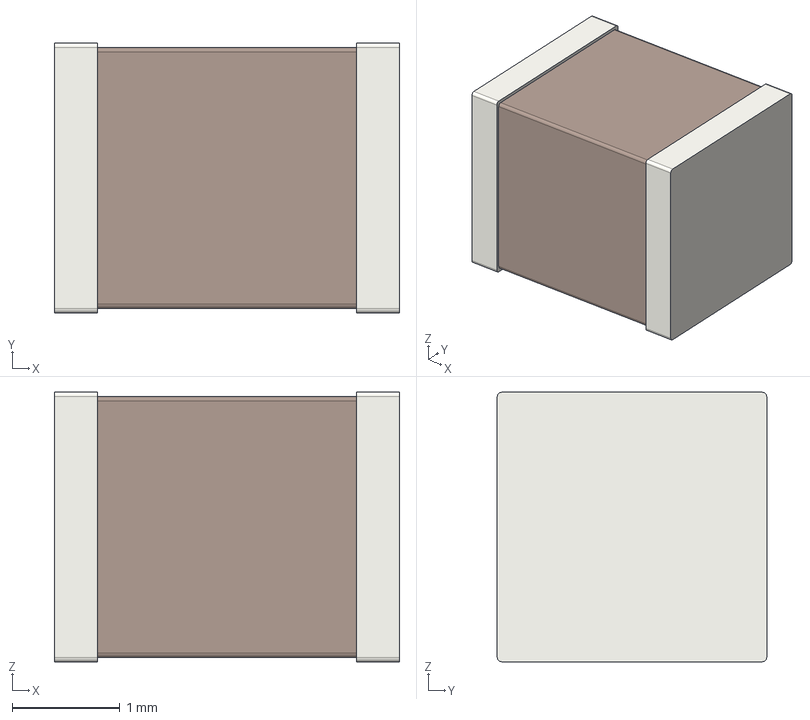
[picture p54: CAD file, 2026-03-07]
3dmodels/C_1210_3225Metric.step
3.20 x 2.50 x 2.50 mm
