fgervais/kicad-library/3dmodels/TSSOP-14_4.4x5mm_P0.65mm.step

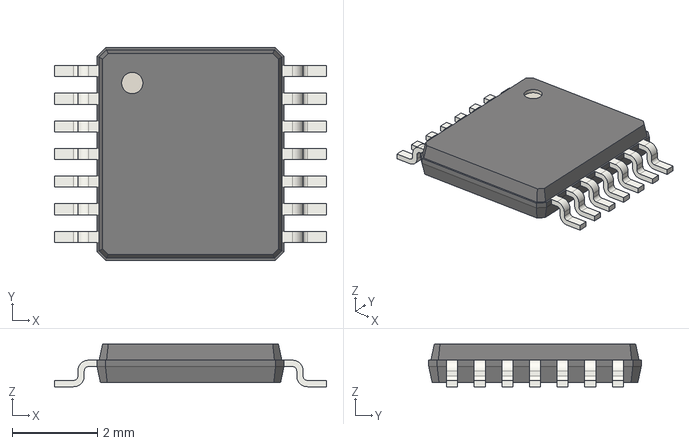
[picture p55: CAD file, 2025-11-14]
3dmodels/TSSOP-14_4.4x5mm_P0.65mm.step
6.40 x 5.00 x 1 mm
