fgervais/kicad-library/3dmodels/WAGO_2060-453-998-404.step

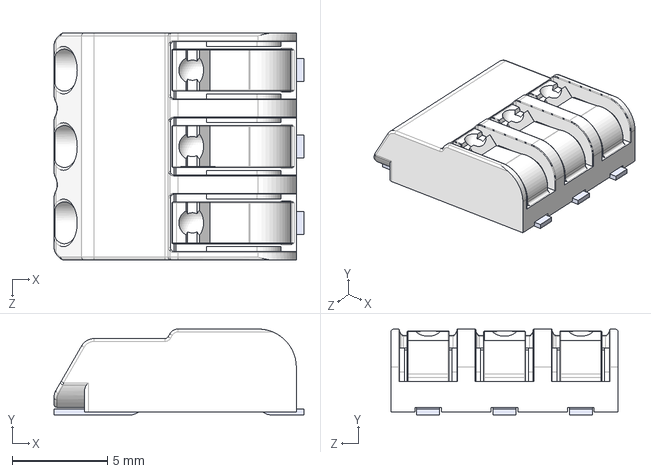
[picture p56: CAD file, 2025-11-14]
3dmodels/WAGO_2060-453-998-404.step
13.1 x 4.50 x 11.9 mm
