fgervais/kicad-library/3dmodels/8-PowerSOIC.step

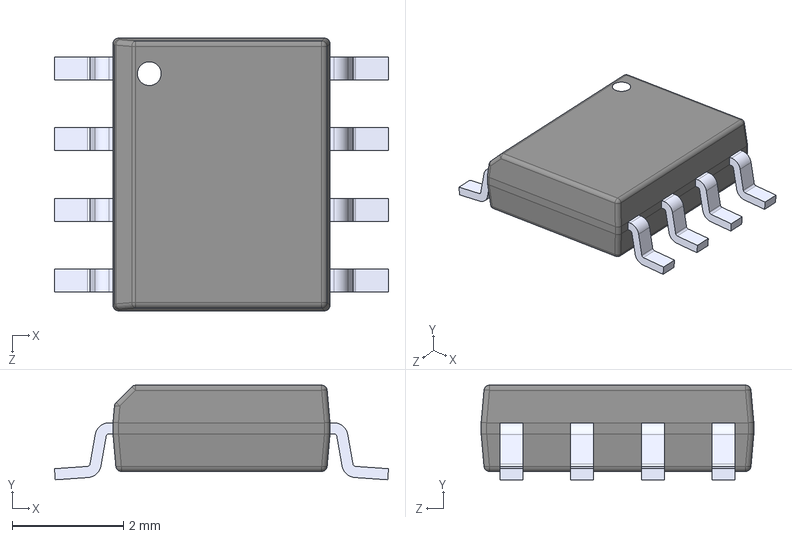
[picture p57: CAD file, 2025-09-29]
3dmodels/8-PowerSOIC.step
6.00 x 1.70 x 4.90 mm
