fgervais/kicad-library/3dmodels/SOT-583-8.step

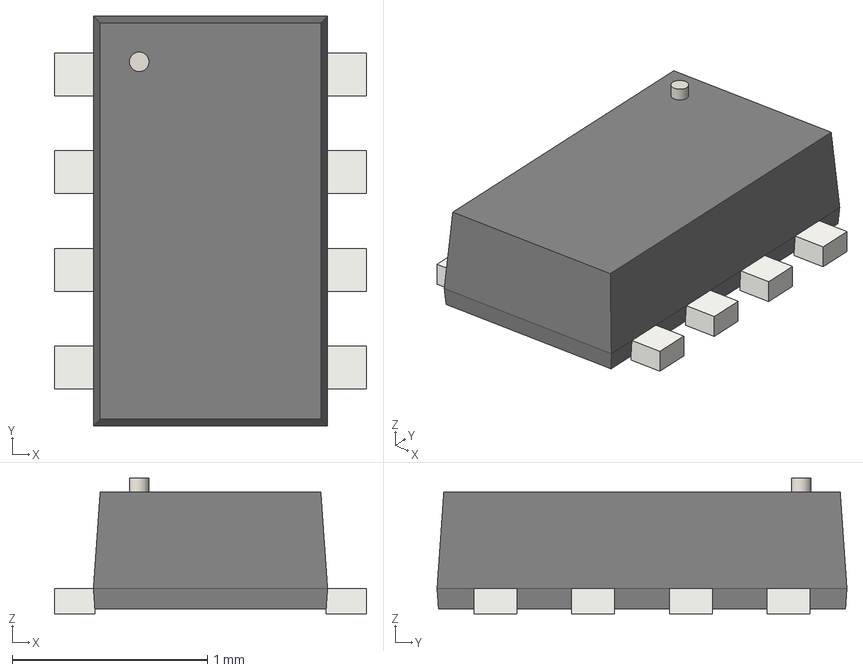
[picture p58: CAD file, 2025-09-27]
3dmodels/SOT-583-8.step
1.60 x 2.10 x 0.695 mm
