fgervais/kicad-library/3dmodels/Keystone_1049P.step

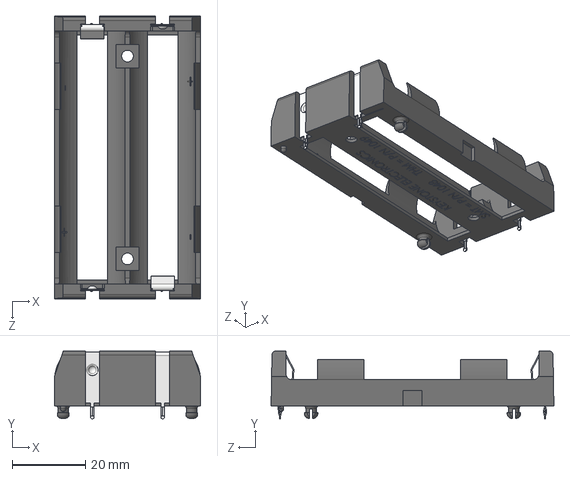
[picture p59: CAD file, 2025-09-27]
3dmodels/Keystone_1049P.step
39.8 x 18.5 x 77.1 mm
