fgervais/kicad-library/3dmodels/D_SOD-523.step

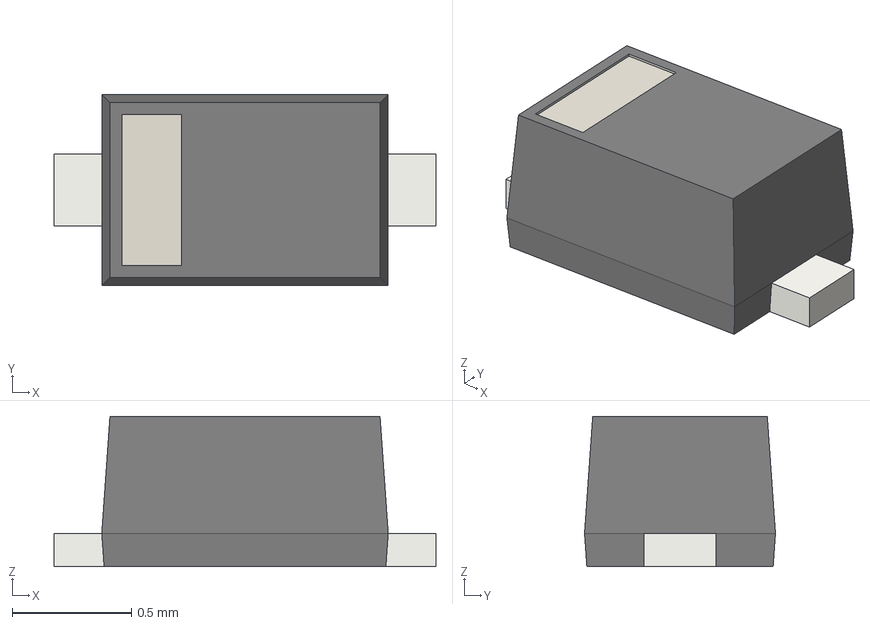
[picture p60: CAD file, 2025-08-20]
3dmodels/D_SOD-523.step
1.60 x 0.8 x 0.63 mm
