fgervais/kicad-library/3dmodels/Amphenol_12402012E212A.step

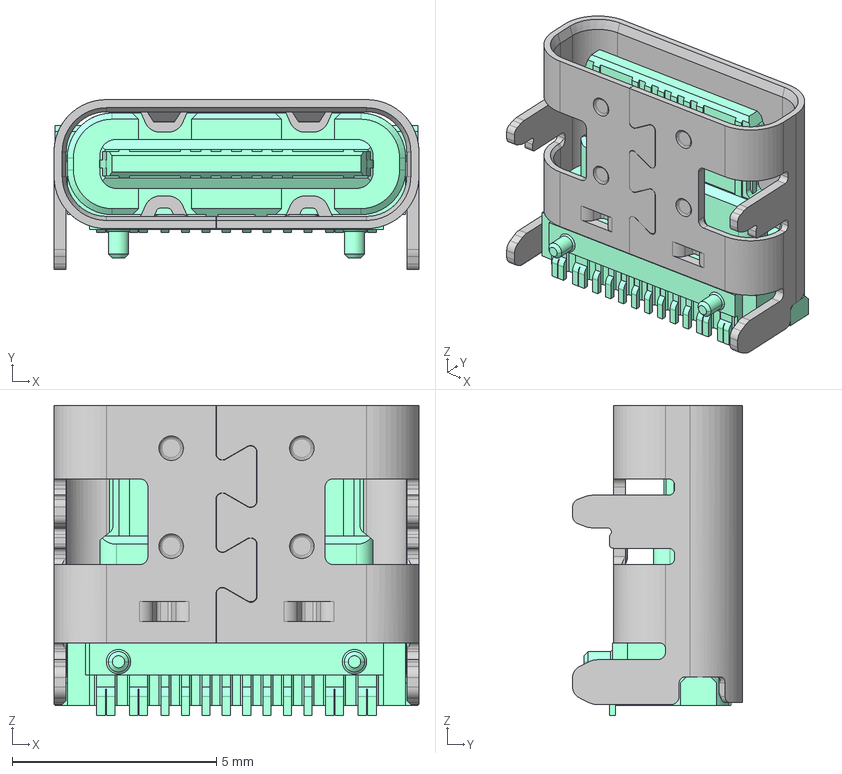
[picture p61: CAD file, 2025-08-16]
3dmodels/Amphenol_12402012E212A.step
8.94 x 4.16 x 7.60 mm
