fgervais/kicad-library/3dmodels/SOT-23F.step

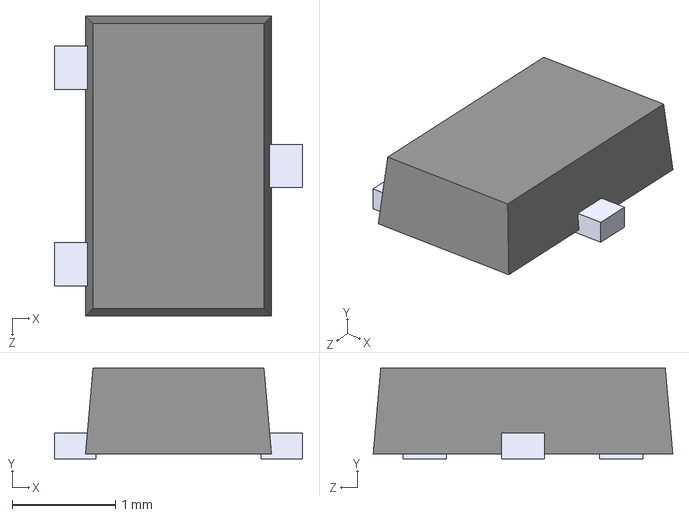
[picture p62: CAD file, 2025-08-16]
3dmodels/SOT-23F.step
2.40 x 0.88 x 2.90 mm
