fgervais/kicad-library/3dmodels/TDK_VLS6045EX-6R8M.step

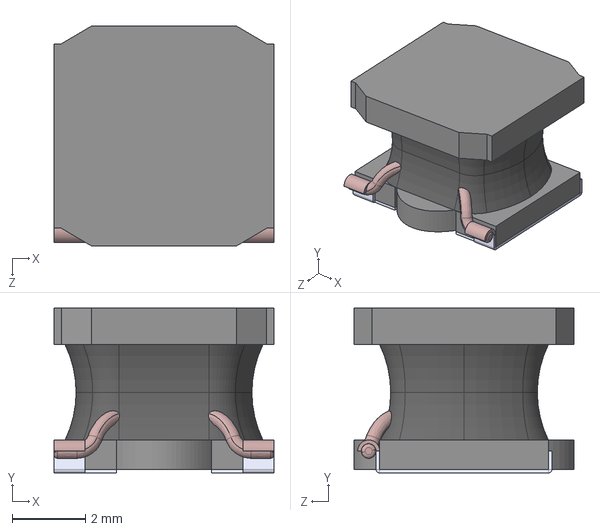
[picture p63: CAD file, 2025-08-16]
3dmodels/TDK_VLS6045EX-6R8M.step
6.00 x 4.50 x 6.00 mm
