fgervais/kicad-library/3dmodels/X2QFN12-RWB0012A.step

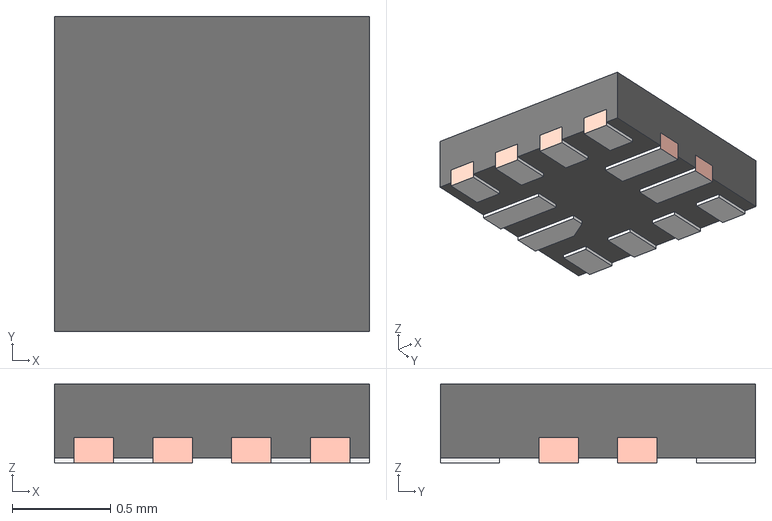
[picture p64: CAD file, 2025-08-16]
3dmodels/X2QFN12-RWB0012A.step
1.60 x 1.60 x 0.4 mm
FRAME-RWB0012A
BODY-QFN
