fgervais/kicad-library/3dmodels/TSOT-23-6.step

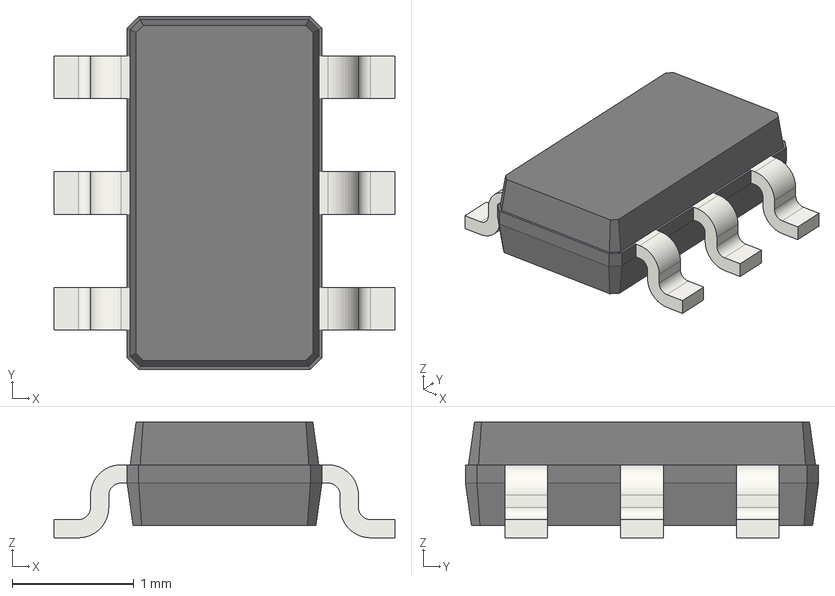
[picture p65: CAD file, 2025-08-16]
3dmodels/TSOT-23-6.step
2.80 x 2.90 x 0.95 mm
