fgervais/kicad-library/(list of files, cad)

Other CAD files:
SOIC127P600X175-8N/SOIC127P600X175-8N.step
1546215-2/1546215-2--3DModel-STEP-1.STEP
1702473/1702473.step
HARTING_15650122601000/15650122601000.stp
KEYSTONE_24949/24949--3DModel-STEP-630548.STEP
SPM10040T_100M/SPM10040T-100M.step
TPS62933DRLR/TPS62933DRLR.step
TZ022101B000G/691508110302 (rev1).stp
TZ042101B000G/691508110304_rev1.stp
