fgervais/kicad-library/(commit log)

2020-11-15 Add multiple parts
    [1546215-2--3DModel-STEP-1.STEP, B2B-PH-K-S(LF)(SN)--3DModel-STEP-56544.STEP, PS1240P02BT--3DModel-STEP-56544.STEP, RJHSE-5080--3DModel-STEP-56544.STEP, a549d9fa911df849d05683749dd4367124007292.step]
2020-12-26 Add ESP32-WROVER-E
2020-12-27 Add MUN5214DW1T1G
    [On_Semiconductor_-_MUN5214DW1T1G.step]
2021-01-18 Add M.2 E Key connector (4.2mm) and bushing
    [sm3zs067u410-nut1-r1200.stp]
2021-01-30 Add S6B-ZR(LF)(SN)
    [S6B-ZR.STEP]
2021-01-31 Add S6B-ZR-SM4A-TF(LF)(SN)
    [S6B-ZR-SM4A-TF_LF__SN_.step]
2021-02-07 Add components
    [BM06B-SRSS-TB.STEP, Molex_-_393570002.step, Molex_-_393570004.step, SOIC127P600X175-8N.step]
2021-02-07 Add buck converter and inductor
2021-02-25 Fix Conn_Molex_39357000x footprint
2021-05-08 Add SM04B-SRSS-TB(LF)(SN)
    [SM04B-SRSS-TB_LF__SN_.step]
2021-08-31 Add DS2482S-100
    [DS2482S-100_.step]
2021-09-24 Add ESP32-C3-WROOM-02-H4
    [ESP32-C3-WROOM-02-H4.step]
2021-09-25 Change ESP32-C3-WROOM-02-H4 step file
    [ESP32-C3-WROOM-02-H4.step]
2022-01-06 Add 3 parts
    [DIO_CUS520_H3F.step, USB4105-GF-A.step]
2022-01-06 Add a new footprint for SSM6J214FE-TE85L-F
2022-01-08 Add p-mosfet step model
    [ES6.step]
2022-03-16 Add 1571563-9 and BA2032SM
    [BA2032SM.step, c-1571563-9-v-3d.stp]
2022-03-24 Add B3FS-1010
    [B3FS-1010.stp]
2022-04-02 Add AS7341-DLGT
    [AS7341-DLGT.step]
2022-04-02 Add TPS7A0233PDBVR
    [TPS7A0233PDBVR.step]
2022-04-10 Add HARTING_15650122601000
    [15650122601000.stp]
2022-04-10 Add PJ-036AH-SMT-TR
    [CUI_DEVICES_PJ-036AH-SMT-TR.step]
2022-04-10 Add ADS1219IPWR
    [ADS1219IPWR.step]
2022-04-10 Add LSF0204DPWR
    [LSF0204DPWR.step]
2022-04-11 Add PHOENIX_1702473
    [1702473.step]
2022-04-22 Add LMV792MM
    [LMV792MM.step]
2022-04-22 Add TXU0204PWR
    [TXU0204PWR.stp]
2022-04-23 Add C12880MA step
    [User Library-C12880MA.STEP]
2022-04-24 Add unconnected pin-4 to TPS7A0233
2022-04-28 Add LP2985-50
    [LP2985-50DBVR.step]
2022-07-01 Add MS88SF3
    [MS88SF3.step]
2022-08-24 Add S2B-PH-SM4-TB(LF)(SN)
    [S2B-PH-SM4-TB_LF__SN_.step]
2022-08-25 Add step file to usb connector
2022-09-17 Add ISM330DHCXTR
    [ISM330DHCXTR.step]
2022-11-02 Add CL-SB-22A-02T
    [CL-SB-22A-02T.step]
2022-11-02 Add TXU0204BQAR
    [BQA0014A.stp]
2022-11-03 Update footprint reference
2022-11-03 Add 0ZCJ0050AF2E
    [0ZCJ0050AF2E.step]
2022-11-13 Add 22R686MC, PKM13EPYH4000-A0, TSM-102-01-L-SH-TR
    [22R686MC.step, PKM13EPYH4000-A0.step, TSM-102-01-L-SH-TR.step]
2022-11-14 Add an SMD footprint to PKM13EPYH4000-A0
2022-11-15 Add BK-5058-SM
    [BK-5058-SM.step]
2022-11-15 Fix some links to footprint
2022-11-17 Add BK-912
    [BK-912-TR.step]
2022-11-18 Remove a bit a silkscreen on the BK912
2022-11-18 Add a 3d model to the TZ022101B000G
    [691508110302 (rev1).stp]
2022-12-15 Change the piezo slot size
2023-01-02 Add PEC11S-9213K-S0015
    [RotaryEncoder_Bourns_PEC11S-929K-S0015-Switch_Vertical.step]
2023-01-02 Rename D/E to S1/S2
    To match kicad's symbol.
2023-01-02 Edit B3FS-1010 to match kicad's symbol pins
2023-01-02 Fix LP2985-50 footprint link
2023-01-02 Fix PJ-036AH-SMT-TR footprint link
2023-01-06 Fix AP63300WU-7 link to footprint + add 3d render
    [sot-23-6.stp]
2023-01-06 Fix AP63300WU-7 footprint font thickness
2023-01-06 Add LBR2518T100K inductor
    [LBR2518T100K.step]
2023-01-07 Change the LBR2518T100K 3d render
    [LBR2518T100K.step, L_QEA251818.STEP]
2023-04-15 Fix Pink_Panda last pin
2023-05-03 Add proto footprints
2023-05-05 Add more proto footprints
2024-04-01 Add TMP117AIDRVR
    [TMP117AIDRVR.step]
2024-04-25 Add PTS810-SJM-250-SMTR-LFS
    [PTS810_SJM_250_SMTR_LFS.step]
2024-04-26 Fix PTS810-SJM-250-SMTR-LFS link to footprint
2024-04-26 Add SolderJumper-2 without center soldermask
2024-04-28 Add 12/16 pin header without silkscreen
2024-04-29 Remove PTS810-SJM-250-SMTR-LFS solder mask expansion
2024-04-29 Make jumper solder mask exclusion the exact size
    It's seems to trouble the DRC that I made it overlap the copper.
2024-10-14 Fix 2/4 pins screw terminals 3d render
2024-10-14 Add BSS138W (BSS138WH6327XTSA1)
    A rebundle of the kicad building blocks
    [SOT-323_SC-70.step]
2024-10-15 Add TZ042101B000G 3d model
    [691508110304_rev1.stp]
2025-01-04 Add SPM10040T_100M
    [SPM10040T-100M.step]
2025-01-04 Add TC33X_2_504E
    [TC33X-2-504E.step]
2025-01-04 Update TC33X footprint link
2025-01-25 Add PWR263S-35
    [pwr263s-35.stp]
2025-01-28 Add WAGO_2060-452-998-404
    [2060-452_998-404.stp]
2025-01-28 Add a tmp117 footprint with top layer only
2025-05-05 Add TCA9548APWR
    [TCA9548APWR.step]
2025-05-05 Add KEYSTONE_24949
    [24949--3DModel-STEP-630548.STEP]
2025-05-06 Add TPS62933DRLR
    [TPS62933DRLR.step]
2025-05-07 Add TPS7A2033PDBVR
    [TPS7A2033PDBVR.step]
2025-05-07 Add CNCTECH_3020-26-0200-00 footprint
2025-05-09 CNCTECH_3220-26-0200-00: add
    [3220-26-0200-00.stp]
2025-05-12 CNCTECH_3220-26-0200-00: remove solder mask extension
2025-05-12 TPS7A2033PDBVR: change footprint type
2025-05-14 CNCTECH_3220-26-0300-00: add
    [3220-26-0300-00.step]
2025-05-14 CNCTECH_3220-26-0300-00: move footprint information
2025-05-14 pink_panda: add symbol and single width footprint
2025-05-18 SM04B: fix footprint type
2025-05-21 TPS62933DRLR: remove soldermask expansion
2025-07-09 TCA9548APWR: match footprint to datasheet
2025-07-09 WAGO_2060-452-998-404: remove soldermask expansion
2025-08-16 TSOT-23-6: add footprint
    [TSOT-23-6.step]
2025-08-16 X2QFN12: add footprint
    [X2QFN12-RWB0012A.step]
2025-08-16 VLS6045EX: add footprint
    [TDK_VLS6045EX-6R8M.step]
2025-08-16 Regulator_Switching/TI_LMR516x5: add symbol
2025-08-16 Rename TSOT footprint library
2025-08-16 Add Toshiba_SSM3J328R
    [SOT-23F.step]
2025-08-16 Add Amphenol_12402012E212A
    [Amphenol_12402012E212A.step]
2025-08-20 Add SOD-523 package
    [D_SOD-523.step]
2025-08-22 Amphenol_12402012E212A: make vbus,gnd >=0.2mm from the mounting hole
2025-08-22 logos: add dragon 16mm
2025-09-12 footprint/SOD-523: reduce copper and solder paste size
2025-09-27 Add Keystone_1049P
    [Keystone_1049P.step]
2025-09-27 Add TI_TPS6293x
    [SOT-583-8.step]
2025-09-29 Add TPS2596xx
    [8-PowerSOIC.step]
2025-09-30 SO.pretty/TI_SO-PowerPAD-8: Change soldermask opening
2025-10-04 Keystone_1049P: update footprint according to 3D drawing sheet
2025-10-04 TPS2596xx: set correct power input/output types
2025-10-05 TI_SO-PowerPAD-8: fix pad soldermask
2025-11-14 Add WAGO_2060-453-998-404
    [WAGO_2060-453-998-404.step]
2025-11-14 Add TI_TXU0104PWR
    [TSSOP-14_4.4x5mm_P0.65mm.step]
2026-01-02 Add Connector_SolderPad/EdgePad_1x1
2026-01-03 EdgePad_1x1: increase length be 0.5 mm
2026-03-07 Add tight version of Capacitor 0603 and 1210
    [C_0603_1608Metric.step, C_1210_3225Metric.step]
2026-03-23 mine/SOIC8-EEPROM-MOD.pretty: switch to castellated holes
